pocketforge-os/test-node-hw/mechanical/dut-cradle-v1/README.md

# PocketForge parametric DUT cradle v1

This is the camera-facing half of a PocketForge test harness: a reusable
**device carrier / DUT cradle** that fixes a handheld at a repeatable optical
datum without loading its controls, triggers, display, or exposed rear wiring.
The first mechanical family supports both the **TrimUI Smart Pro** and
**TrimUI Smart Pro S**, which share the same enclosure and control layout.
The compact portrait profile supports the **TrimUI Brick** while reusing the
same proven M3/keyway hook mechanism; see
[`README-trimui-brick.md`](README-trimui-brick.md).
That profile remains a qualification candidate until the owner accepts its
printed fit, retention, service clearance, and webcam framing.
The landscape **Powkiddy X55** candidate preserves the owner-traced contact
outline, three provisional local-depth hook profiles, crowded top/bottom edge
keep-outs, and open short ends; see
[`README-powkiddy-x55.md`](README-powkiddy-x55.md). Print its fit coupon first;
exact local depths remain gated by `tsp-bcx.21.28`.

The carrier is deliberately not a tight six-point vise. Two lower hooks carry
the device, the removable upper pair captures it, and the two lateral hooks are
loose datums. Every hook has a rear shelf, so the six perimeter contacts—not
the open PCB and not the shoulder triggers—establish an 11 mm carrier gap.

## Why separate parts

OpenSCAD modules are the template mechanism:

- [`lib/dut-cradle-library.scad`](lib/dut-cradle-library.scad) contains the
  reusable carrier fastener and J-hook geometry.
- [`trimui-smart-pro-family-cradle.scad`](trimui-smart-pro-family-cradle.scad)
  contains the shared mechanical profile: shell dimensions, optical offset,
  contact windows, hook poses, labels, and common 4040 datum.
- [`trimui-smart-pro-s-cradle.scad`](trimui-smart-pro-s-cradle.scad) and
  [`trimui-smart-pro-cradle.scad`](trimui-smart-pro-cradle.scad) are tiny model
  wrappers that supply `TrimUI Smart Pro S / TG5050` or
  `TrimUI Smart Pro / TG5040` as the raised marketing/internal-model title.
- [`trimui-brick-cradle.scad`](trimui-brick-cradle.scad) supplies the Brick's
  portrait plate, stepped-depth preview, five contact poses, and two hook
  profiles while importing the same reusable hook implementation.
- [`powkiddy-x55-cradle.scad`](powkiddy-x55-cradle.scad) supplies the X55's
  247 × 175 mm landscape carrier, curved-shell preview, six contact poses, and
  three edge-specific hook profiles.

A future handheld gets a new wrapper/profile while reusing the library. The
carrier envelope and eight corner frame anchors remain standardized; the
device outline, service aperture, safe contacts, and optical center may change.
Every device profile reserves a dedicated top margin for a centered, horizontal
device-name title box; names do not use side margins or share space with clamp
mounts. Orientation labels may move to suit the device-specific keep-outs.

`PART` selects independent printable objects:

| `PART` | Result |
|---|---|
| `assembly` | Default presentation; exports only the carrier because DUT, safe windows, and installed hooks are background geometry |
| `plate` | Carrier plate |
| `presentation_body` | Presentation-only carrier body below the filament-change layer; do not print separately |
| `presentation_labels` | Presentation-only title, border, and orientation labels for the selected wrapper; do not print separately |
| `title_text` | Audit-only export of the registered device title with its production font, size, and stroke growth; do not print separately |
| `hook` | One J-hook, already laid on its strong printing side |
| `hook_set` | Six production J-hooks arranged for one print |
| `installed_hooks` | Presentation-only mesh of all six hooks at their installed carrier coordinates; do not print |
| `fit_coupon` | Three throat/nut variants plus the production screw-slot/keyway coupon |

There is only one hook implementation and one single-hook export. `hook_set`
instances that same parameterized module six times for slicer convenience; it
does not duplicate source geometry. A future device family reuses the library
and supplies its own throat, stand-off, fastener, and contact parameters.

## Print the coupon first

```sh
make build/fit-coupon.stl
```

The three hooks all use the production 11.3 mm throat and are ordered
left-to-right by M3 nut-pocket size:

1. 5.5 mm across flats;
2. 5.6 mm across flats (production default);
3. 5.7 mm across flats.

The detached coupon plate contains the production 3.5 mm M3 adjustment slot
and shallow anti-rotation keyway. Check the actual device edge at all proposed
contact regions: 11.3 mm is the owner-corrected internal capture gap after the
first physical fit, not a claim that shell thickness is uniform. A thin 0.5–1
mm felt or TPU contact pad is recommended for the final hooks.

## Build and validate

```sh
make preview
make validate
```

Generated STLs and PNGs live under `build/`, remain uncommitted, and are
published as a GitHub Actions artifact on relevant pushes. The main outputs are
`trimui-smart-pro-s-carrier.stl`, `trimui-smart-pro-carrier.stl`, `j-hook.stl`,
and `j-hook-set.stl`, plus the `trimui-brick-*` carrier/hook/coupon exports
listed in the Brick README. The additional
`trimui-smart-pro-family-installed-hooks.stl` is a presentation asset consumed
by the parent chassis model; it is deliberately separate from both production
carrier exports and must not be sent to a slicer. The generated family carrier
body plus base/S label meshes are likewise presentation-only: together they
preserve the white-body/black-label material split in imported chassis views,
while each production carrier remains one unified printable STL.

Validation parses every repository OpenSCAD source, renders all meshes, proves
the 247 × 200 mm plate fits the conservative 247 × 207 mm Prusa envelope,
rejects an undersized hook throat, and proves preview-only geometry cannot leak
into either carrier export. A family-equivalence guard also exports both plates
without labels and proves their mechanical meshes are byte-for-byte equivalent
at the triangle level; the raised title is the only model difference.
Validation also bounds-checks the presentation-only installed-hook mesh so the
chassis view cannot silently drift away from the accepted six-hook layout.
Brick guards independently reject a non-flat front datum, rear finger
clearance below 8 mm, contact on the lower corner transition, insufficient
print-foot area, and title/mount overlap. The profile registry also exports the
actual title text mesh for every registered device and requires at least 2.4 mm
of clearance from all four inner title-border edges.

## Qualified geometry regression

The fit-bearing Smart Pro family geometry is physically qualified, not merely
renderable. The owner accepted the final carrier/retention fit on 2026-07-21
under Bead `tsp-bcx.21.22`; the accepted settings are the 11.3 mm hook throat,
11 mm trigger/rear gap, 5.6 mm nut pocket, and 2.4 mm nut-capture wall.

[`qualification/trimui-smart-pro-family-v1.json`](qualification/trimui-smart-pro-family-v1.json)
records normalized geometry identities and review metrics for:

- the unlabelled, fit-bearing carrier body;
- one production J-hook;
- the six-hook print set; and
- the fit coupon used to establish the retained dimensions.

Labels and the installed-hook presentation mesh are deliberately excluded.
They do not establish contact with the DUT. The manifest stores no STL:
production meshes remain generated under `build/`.

Run the check directly or through full validation:

```sh
make validate-qualified validate-qualified-mutation
make validate
```

The fingerprint quantizes coordinates to 0.0001 mm and then ignores STL
headers, normals, binary attribute bytes, facet order, winding, starting
vertex, and signed zero. This makes ASCII and binary exports of identical
geometry share an identity. The quantum is 0.1 micrometre—far below the target
FDM process—so it does not mask a printable change. Bounds, area, volume, and
topology remain alongside the digest as reviewable characterization data.

The mutation guard renders a valid, in-bounds hook with an 11.4 mm throat. It
must fail the qualified fingerprint even though ordinary OpenSCAD and bounds
checks pass. Relevant pull requests run this complete check, not lint alone.
The CI compatibility lock is Ubuntu 24.04 plus the
`openscad=2021.01-6build4` package; the checker also requires OpenSCAD to report
version 2021.01.

### Intentional geometry changes

A failing qualification check is not an instruction to refresh the manifest.
First inspect the geometric change, print the appropriate coupon or full
holder, and obtain explicit physical acceptance against the named device
hardware revision. The record command is intentionally separate from every
normal Make/CI path and refuses to operate without an acceptance reference and
`--confirm-physical-acceptance`:

```sh
python3 scripts/qualified_geometry.py --root . record \
  --manifest qualification/trimui-smart-pro-family-v1.json \
  --acceptance-ref <bead-or-approval-record> \
  --accepted-source-revision <physically-tested-commit> \
  --characterized-source-revision <current-commit> \
  --accepted-on <YYYY-MM-DD> \
  --confirm-physical-acceptance
```

Without `--write`, that command prints a review candidate and changes nothing.
Add `--write` only as the deliberate source edit after physical qualification;
review the manifest diff like any other fit-bearing CAD change.

The normalized digest answers “is this the same geometry?” Raw STL SHA256
answers “is this the same distributed file?” Release print packs should carry
raw checksums, but representation-dependent file hashes are not substitutes
for this qualification gate. Neither form proves that future measurements are
correct: a new device or changed contact surface still requires an in-hand fit
gate.

## Hardware and assembly

- 6 printed J-hooks (PETG preferred);
- 6 × M3 nuts (coupon tests 5.5, 5.6, and 5.7 mm across-flat pockets);
- 6 × M3 × 12 mm pan-head machine screws;
- 6 × M3 washers under the plate;
- optional thin felt/TPU pads at shell contacts;
- 8 heavy-duty cable ties for the 4040-frame anchors.

Assembly order:

1. Insert each nut from the top of its hook base.
2. Loosely install the two bottom hooks from the rear of the carrier. Their
   rectangular keys must enter the shallow guide channels.
3. Lower the DUT onto the two rear shelves. The screws lock hook position; do
   **not** tighten the hooks inward to squeeze the shell.
4. Set the side hooks with roughly 0.6 mm play and tighten them.
5. Install the top hooks last with roughly 0.45 mm play. These are the only
   hooks normally removed when servicing the DUT.
6. Confirm every trigger, button, connector, speaker/vent, wire, and the full
   display remains free before mounting the carrier to the 4040 frame.

M3 × 12 is the calculated starting length for a 3.2 mm carrier, 4.4 mm hook
base, washer, and 2.4 mm-class nut. Verify it on the coupon. The screw and nut
sit 8 mm outside the shell edge, so excess length cannot point into the DUT.
Each nut pocket has a complete 2.4 mm radial capture wall—three extrusion widths
with the lab's 0.8 mm nozzle—so tightening torque cannot spin the nut out through
the side of the formerly narrow base.

## Profile measurements and assumptions

| Parameter | Current value | Status |
|---|---:|---|
| Shell envelope | 188.35 × 79.77 mm | Owner measurement |
| Modeled local edge depth | 10.7 mm | Preview proxy derived from fit gap and passive clearance |
| Production hook throat | 11.3 mm | Owner correction after first physical fit |
| Rear carrier gap | 11.0 mm | Owner correction: original 6 mm + 5 mm trigger clearance |
| Front lip overlap | 2.8 mm | Design choice; below screen margin |
| Rear service aperture | 158 × 52 mm | Design choice; leaves perimeter structure |
| Top-left safe window | 35.41–50 mm from left | Interpreted from nested sketch dimensions |
| Top-right safe window | 34–50 mm from right | Interpreted from nested sketch dimensions |
| Bottom safe windows | 24–35 mm from each end | Interpreted from nested sketch dimensions |
| Active screen proxy | 110.8 × 62.3 mm | Preview-only provisional estimate |
| Screen optical offset | [0, 0] | Independent, awaiting camera registration |

The paper sketch appears to mark each mountable region between the two nested
dimension endpoints; clamp centers use those interval midpoints. Green bars in
the assembly preview make this assumption visible. Adjust the four named safe
windows if that reading is wrong—nothing in the reusable hook changes.

## Print settings

- Carrier: flat, labels upward, no support; PETG preferred.
- Hooks: the STL already lays each hook on its broad side so layers run through
  the J profile; no support.
- Start at 0.30–0.40 mm layers for the 0.8 mm nozzle, 4 perimeters, 5 top/bottom
  layers, and 20–30% gyroid. Use the slicer's preview to verify the 1.2 mm-deep
  anti-rotation channels and 1.2 mm raised labels survive the selected layer
  height.
- The device name and TOP/BOTTOM markings use the profile's locked Liberation
  face with 0.35 mm stroke expansion. Smart Pro and Smart Pro S retain their
  passing 10 mm titles; Brick uses 8.5 mm and X55 uses 11.0 mm so every title
  remains at least three 0.8 mm nozzle widths inside its border.
- Print the carrier body in white, then change to black at `plate_thickness`
  (3.2 mm), where the raised title, title-box border, and TOP/BOTTOM markings
  begin. The OpenSCAD assembly uses this same datum for its material colors.
- The large central aperture is intentional: it saves material, improves
  airflow, keeps the open PCB/wiring untouched, and permits rear service.
