pocketforge-os/test-node-hw/mechanical/dut-fixture-v1/VIENON-USB-001-PROVENANCE.md

# VIENON Usb-001 model provenance

`vienon-usb-001.scad` is an original PocketForge reconstruction of the black
bottom-facing USB hub installed on the fixture. No listing image or third-party
geometry is redistributed.

## Identity and dimensions

- Owner-supplied listing: <https://www.amazon.com/dp/B09MLRPTT2>
- Brand/model: VIENON Usb-001, UPC 743890190214
- Product: ultra-slim four-port USB-A hub with fixed one-foot upstream lead
- Published envelope: 3.94 × 1.18 × 0.39 in, approximately
  100 × 30 × 10 mm
- Port population: one USB 3.0 plus three USB 2.0 data ports and blue status
  indicator. Gallery revisions color all four receptacle tongues blue; the
  model keeps one blue USB 3.0 tongue and three dark USB 2.0 tongues according
  to the listing's explicit interface specification.
- Fixture pose: four downstream ports face −Y/bottom and the fixed upstream
  lead exits +X/right, matching the owner photograph

The prior 105 × 24 mm analytical envelope was an allowed estimate. The exact
body is centred on the physically proven X tie axes. Only the presentation
body moves 2 mm toward the open plate edge; the printable tie slots are
unchanged.

## Preserved references

The Amazon gallery was saved outside git under
`/home/matt/Downloads/pocketforge-reference/final-fixture-components/vienon-usb-001/B09MLRPTT2/`
on 2026-07-26. The adjacent `SOURCES.txt` records every file and hash. Key
files are:

- Hero: `3129YkhBboL.jpg`,
  SHA-256 `3c751f1dbf784083af1d7ea2ee700e7ddbccd587d77e17dfada458fb3011dc63`
- Four-device usage view: `51TMyUDboPL.jpg`,
  SHA-256 `299d28ef6c14c95fc19dbe0de5367313f78e47066a62850ba105745512a0ebe7`
- Internal population view: `516wx7kZkOL.jpg`,
  SHA-256 `f5161ac65919ef52bc03edad6fed35815246ff483af24d3269169fc67b3c423a`
- Owner installed-state photo:
  SHA-256 `01ecb407d5862a442ac77eb52c60763db44b5067d2c55e2e0d08fc6aed7d51e5`

## Geometry and license decision

Exact ASIN, UPC, model-number, STEP, STL, and CAD searches found no matching
model with a redistribution license. The source reconstructs the crowned ABS
shell, four receptacles, differentiated port tongues, LED, seam, fixed cable,
strain relief, and visible upstream USB-A plug.

Searches used `B09MLRPTT2`, `743890190214`, `VIENON Usb-001`, and their
combinations with `STEP`, `STL`, `CAD`, and `3D model` across general search
and public CAD-model indexes. No exact geometry candidate was found, so there
is no third-party author or license to carry forward; visually similar
unbranded four-port hubs were rejected as unverifiable revisions.
