pocketforge-os/test-node-hw/mechanical/dut-cradle-v1/trimui-brick-cradle.scad

/*
 * PocketForge reusable DUT cradle — TrimUI Brick profile
 *
 * Coordinates: X left-to-right, Y bottom-to-top, Z toward the webcam; mm.
 * The Brick has a stepped rear shell.  Per-hook rear shelves compensate for
 * that step so the front glass remains parallel to the carrier and camera.
 *
 * PART choices: assembly, plate, presentation_body, presentation_labels,
 * bottom_support, side_hook, upper_hook, hook_set, fit_coupon.
 * Preview geometry is background-only and cannot leak into printable exports.
 */

include <lib/dut-cradle-library.scad>;

PART = "assembly";
DEVICE_LABEL = "TrimUI Brick / TG3040";
SHOW_DEVICE = true;
SHOW_HOOKS = true;
SHOW_KEEP_OUTS = true;
SHOW_LABELS = true;

$fn = 48;
epsilon = 0.05;

// ---- Carrier / printer datum ---------------------------------------------
printer_bed = [250, 210];
printer_edge_margin = 1.5;
printable_bed = printer_bed - [2 * printer_edge_margin,
                               2 * printer_edge_margin];

// The 205 mm height reserves the same top-title convention as the accepted
// Smart Pro carriers while staying inside the conservative 207 mm Y envelope.
plate_size = [180, 205];
plate_thickness = 3.2;
plate_corner_radius = 4.0;

frame_tie_slot = [12.0, 5.5];
frame_tie_edge_inset = 7.0;
frame_tie_corner_offset = 18.0;
frame_tie_features = [
    ["bottom_left_bottom", [frame_tie_corner_offset, frame_tie_edge_inset], 0],
    ["bottom_left_left", [frame_tie_edge_inset, frame_tie_corner_offset], 90],
    ["bottom_right_bottom",
     [plate_size.x - frame_tie_corner_offset, frame_tie_edge_inset], 0],
    ["bottom_right_right",
     [plate_size.x - frame_tie_edge_inset, frame_tie_corner_offset], 90],
    ["top_left_top",
     [frame_tie_corner_offset, plate_size.y - frame_tie_edge_inset], 0],
    ["top_left_left",
     [frame_tie_edge_inset, plate_size.y - frame_tie_corner_offset], 90],
    ["top_right_top",
     [plate_size.x - frame_tie_corner_offset,
      plate_size.y - frame_tie_edge_inset], 0],
    ["top_right_right",
     [plate_size.x - frame_tie_edge_inset,
      plate_size.y - frame_tie_corner_offset], 90]
];

// ---- Owner-measured Brick mechanical profile -----------------------------
device_name = DEVICE_LABEL;
device_body_size = [72.8, 110.75];
device_bottom_corner_radius = 8.5;
device_origin = (plate_size - device_body_size) / 2;
device_centre = device_origin + device_body_size / 2;

// The lower 60 mm of the shell is 20 mm deep; the upper shell is 12 mm deep.
// Supporting the two regions 8 mm apart holds their shared front face flat.
lower_region_height = 60.0;
lower_body_depth = 20.0;
upper_body_depth = 12.0;
minimum_rear_clearance = 8.0;
lower_rear_gap = 10.0;
upper_rear_gap = lower_rear_gap + lower_body_depth - upper_body_depth;

// 3.2-inch 4:3 panel geometry.  Only the top margin is a hook safety datum;
// the rest is a preview until a direct glass measurement is needed.
screen_size = [65.02, 48.77];
screen_top_margin = 1.8;
screen_origin = [
    device_origin.x + (device_body_size.x - screen_size.x) / 2,
    device_origin.y + device_body_size.y - screen_top_margin - screen_size.y
];

// Large open back for trigger testing, airflow, wiring, and a finger behind
// the DUT.  The remaining perimeter carries all five clamp interfaces.
rear_service_window = [56.0, 86.0];
rear_service_origin = device_centre - rear_service_window / 2;
rear_service_radius = 7.0;

// ---- Five passive contacts -----------------------------------------------
// Two rear-only bottom supports carry weight without crossing the bottom I/O
// insertion plane. Two side hooks are loose datums, and the narrow upper hook
// is offset left of the centred USB-host path and only prevents escape.
bottom_contact_inset = 18.0;
// Keep the complete 9 mm side-contact band above the 8.5 mm lower corner arc.
lower_side_contact_height = 14.0;
upper_contact_inset = 17.0;

lower_throat = lower_body_depth + 0.6;
upper_throat = upper_body_depth + 0.6;

// pose = [name, exact shell-edge contact point, inward angle, play, kind]
clamp_poses = [
    ["bottom_left",
     [device_origin.x + bottom_contact_inset, device_origin.y],
     90, 0.25, "bottom"],
    ["bottom_right",
     [device_origin.x + device_body_size.x - bottom_contact_inset,
      device_origin.y],
     90, 0.25, "bottom"],
    ["left_lower_datum",
     [device_origin.x, device_origin.y + lower_side_contact_height],
     0, 0.60, "side"],
    ["right_lower_datum",
     [device_origin.x + device_body_size.x,
      device_origin.y + lower_side_contact_height],
     180, 0.60, "side"],
    ["upper_retainer",
     [device_origin.x + upper_contact_inset,
      device_origin.y + device_body_size.y],
     -90, 0.45, "upper"]
];

function pose_name(pose) = pose[0];
function pose_contact(pose) = pose[1];
function pose_angle(pose) = pose[2];
function pose_play(pose) = pose[3];
function pose_kind(pose) = pose[4];
function pose_inward(pose) = pf_rotate_2d([1, 0], pose_angle(pose));
function pose_surface(pose) =
    pf_add_2d(pose_contact(pose),
              pf_scale_2d(-pose_play(pose), pose_inward(pose)));

// ---- Shared hook hardware / two contact profiles -------------------------
bottom_support_width = 9.0;
side_hook_width = 9.0;
upper_hook_width = 6.0;
hook_wall = 4.0;
side_lip_depth = 3.0;
upper_lip_depth = 1.2;
hook_lip_thickness = 4.0;
bottom_support_depth = 4.0;
side_support_depth = 4.0;
upper_support_depth = 3.0;
hook_support_thickness = 3.2;
bottom_io_min_z = 7.0;
bottom_io_clearance = 1.0;
bottom_support_stem_height = lower_rear_gap + 4.0;
hook_base_outward = 13.0;
hook_base_inward = 4.0;
hook_base_height = 4.4;
hook_base_radius = 1.5;
// Keep a Smart-Pro-width spine/base for a full broad-side first layer while
// leaving the 9/6 mm shell-contact shelves and lips narrow. This preserves the
// already-printed carrier's keyway locations and all device keep-outs.
hook_spine_width = 10.4;

m3_clearance = 3.5;
m3_nut_across_flats = 5.6;               // Smart Pro owner-validated press fit
m3_nut_depth = 2.8;
m3_nut_capture_wall = 2.4;
hook_screw_offset = [-8.0, -3.5];
hook_key_offset = [-8.0, 3.5];
hook_key_size = [4.0, 3.2];
hook_key_clearance = 0.35;
hook_keyway_depth = 1.2;
hook_adjustment = 8.0;
print_face_margin = 0.10;

// ---- Labels for the 0.8 mm nozzle ----------------------------------------
label_height = 1.2;
label_stroke_growth = 0.35;
label_font = "Liberation Sans:style=Regular";
title_box_size = [124.0, 24.0];
title_box_centre = [plate_size.x / 2, plate_size.y - 15.0];
title_font_size = 8.5;
title_border_inner_inset = 1.2;
orientation_font_size = 10.5;
label_feature_clearance = 2.4;  // three 0.8 mm nozzle widths
carrier_body_color = [0.88, 0.88, 0.84];
carrier_label_color = [0.02, 0.02, 0.02];

top_label_center = [plate_size.x - 25.0, plate_size.y - 36.0];
bottom_label_center = [plate_size.x / 2, 11.5];

// ---- Explicit mechanical invariants --------------------------------------
lower_front_datum = lower_rear_gap + lower_throat;
upper_front_datum = upper_rear_gap + upper_throat;
top_usb_keepout = [
    device_origin.x + device_body_size.x / 2 - 8.0,
    device_origin.x + device_body_size.x / 2 + 8.0
];
upper_contact_window = [
    device_origin.x + upper_contact_inset - upper_hook_width / 2,
    device_origin.x + upper_contact_inset + upper_hook_width / 2
];
title_box_min = title_box_centre - title_box_size / 2;
title_box_max = title_box_centre + title_box_size / 2;
top_left_slot_outer_x = frame_tie_corner_offset + frame_tie_slot.x / 2;
top_right_slot_inner_x = plate_size.x - frame_tie_corner_offset -
                         frame_tie_slot.x / 2;
upper_hook_surface = pose_surface(clamp_poses[4]);
upper_hook_screw_point = pf_add_2d(
    upper_hook_surface,
    pf_rotate_2d(hook_screw_offset, pose_angle(clamp_poses[4]))
);
upper_mount_outer_y = max(
    upper_hook_surface.y + hook_base_outward,
    upper_hook_screw_point.y + (hook_adjustment + m3_clearance) / 2
);
top_label_outer_y = top_label_center.y +
                    orientation_font_size / 2 + label_stroke_growth;
bottom_label_outer_y = bottom_label_center.y +
                       orientation_font_size / 2 + label_stroke_growth;
bottom_left_surface = pose_surface(clamp_poses[0]);
bottom_left_screw_point = pf_add_2d(
    bottom_left_surface,
    pf_rotate_2d(hook_screw_offset, pose_angle(clamp_poses[0]))
);
bottom_mount_inner_y = bottom_left_screw_point.y -
                       (hook_adjustment + m3_clearance) / 2;

assert(plate_size.x <= printable_bed.x && plate_size.y <= printable_bed.y,
       "Brick carrier exceeds the conservative Prusa printable envelope");
assert(lower_rear_gap >= minimum_rear_clearance,
       "Brick lower rear gap must preserve finger access");
assert(upper_rear_gap >= minimum_rear_clearance,
       "Brick upper rear gap must preserve trigger access");
assert(abs(lower_front_datum - upper_front_datum) < 0.01,
       "Brick front contact plane must remain flat across shell step");
assert(lower_throat > lower_body_depth && upper_throat > upper_body_depth,
       "Brick hook throats must retain positive passive clearance");
assert(upper_lip_depth < screen_top_margin,
       "Brick upper lip could cover active screen pixels");
assert(upper_contact_window.y < top_usb_keepout.x,
       "Brick upper retainer entered the centred USB-host keep-out");
assert(title_box_min.x >= top_left_slot_outer_x + label_feature_clearance &&
       title_box_max.x <= top_right_slot_inner_x - label_feature_clearance,
       "Brick top title box entered a top 4040 frame slot lane");
assert(title_box_min.y >= upper_mount_outer_y + label_feature_clearance,
       "Brick top title box entered the upper hook adjustment sweep");
assert(top_label_outer_y + label_feature_clearance <= title_box_min.y,
       "Brick TOP orientation label entered the device title box");
assert(bottom_label_outer_y + label_feature_clearance <=
           bottom_mount_inner_y,
       "Brick BOTTOM label entered a lower hook adjustment sweep");
assert(lower_side_contact_height - side_hook_width / 2 >
           device_bottom_corner_radius &&
       lower_side_contact_height + side_hook_width / 2 <
           lower_region_height,
       "The complete Brick side-contact band must land on the straight thick shell");
assert(bottom_support_stem_height <=
           lower_rear_gap + bottom_io_min_z - bottom_io_clearance,
       "Brick bottom supports entered the bottom I/O insertion plane");
assert(m3_nut_capture_wall >= 2.4,
       "Brick M3 nut capture wall must remain at least three nozzle widths");
assert(hook_key_offset.y + hook_key_size.y / 2 + print_face_margin <=
           hook_spine_width / 2,
       "Brick anti-rotation keys must not protrude below the broad print face");
assert(rear_service_origin.x > device_origin.x &&
       rear_service_origin.y > device_origin.y &&
       rear_service_origin.x + rear_service_window.x <
           device_origin.x + device_body_size.x &&
       rear_service_origin.y + rear_service_window.y <
           device_origin.y + device_body_size.y,
       "Brick service aperture must remain inside the DUT footprint");

// ---- Carrier --------------------------------------------------------------
module embossed_text(point, message, size, rotation = 0,
                     halign = "center") {
    translate([point.x, point.y, plate_thickness])
        linear_extrude(height = label_height)
            rotate(rotation)
                offset(delta = label_stroke_growth)
                    text(message, size = size, halign = halign,
                         valign = "center",
                         font = label_font);
}

// Preserve the 124 x 24 mm placard and orientation-label sizes while keeping
// the longer marketing/model title three nozzle widths inside its border.
module carrier_title_contract() {
    assert(is_undef(EXPECTED_TITLE_BOX_SIZE) ||
           title_box_size == EXPECTED_TITLE_BOX_SIZE,
           "Carrier title box size drifted from its profile contract");
    assert(is_undef(EXPECTED_TITLE_BOX_CENTRE) ||
           title_box_centre == EXPECTED_TITLE_BOX_CENTRE,
           "Carrier title box centre drifted from its profile contract");
    assert(is_undef(EXPECTED_TITLE_FONT_SIZE) ||
           title_font_size == EXPECTED_TITLE_FONT_SIZE,
           "Carrier title font size drifted from its profile contract");
    assert(is_undef(EXPECTED_TITLE_BORDER_INSET) ||
           title_border_inner_inset == EXPECTED_TITLE_BORDER_INSET,
           "Carrier title border inset drifted from its profile contract");
}

module title_border(centre, size) {
    translate([centre.x - size.x / 2,
               centre.y - size.y / 2,
               plate_thickness]) {
        linear_extrude(height = label_height)
            difference() {
                pf_rounded_rect_2d(size, 2.0);
                translate([title_border_inner_inset,
                           title_border_inner_inset])
                    pf_rounded_rect_2d(
                        size - [2 * title_border_inner_inset,
                                2 * title_border_inner_inset],
                        title_border_inner_inset
                    );
            }
    }
}

module carrier_title_text() {
    carrier_title_contract();
    translate([title_box_centre.x, title_box_centre.y, plate_thickness])
        linear_extrude(height = label_height)
            offset(delta = label_stroke_growth)
                text(device_name, size = title_font_size,
                     halign = "center", valign = "center",
                     font = label_font);
}

module carrier_labels() {
    title_border(title_box_centre, title_box_size);
    carrier_title_text();
    embossed_text(top_label_center, "TOP", orientation_font_size);
    embossed_text(bottom_label_center, "BOTTOM",
                  orientation_font_size);
}

module carrier_body() {
    difference() {
        pf_rounded_prism(
            [plate_size.x, plate_size.y, plate_thickness],
            plate_corner_radius
        );

        pf_frame_tie_holes(
            frame_tie_features, frame_tie_slot,
            plate_thickness + 2 * epsilon
        );

        translate([rear_service_origin.x, rear_service_origin.y,
                   -epsilon])
            linear_extrude(height = plate_thickness + 2 * epsilon)
                pf_rounded_rect_2d(rear_service_window,
                                   rear_service_radius);

        for (pose = clamp_poses)
            pf_clamp_mount_cutouts(
                pose_surface(pose), pose_angle(pose), plate_thickness,
                hook_screw_offset, hook_key_offset, hook_adjustment,
                m3_clearance, hook_key_size, hook_key_clearance,
                hook_keyway_depth, epsilon
            );
    }
}

module carrier_plate() {
    union() {
        carrier_body();
        if (SHOW_LABELS)
            carrier_labels();
    }
}

// The physical carrier changes from white to black exactly where its raised
// geometry begins. Keep that split presentation-only: PART="plate" remains
// one fused printable mesh.
module carrier_presentation() {
    color(carrier_body_color) carrier_body();
    if (SHOW_LABELS)
        color(carrier_label_color) carrier_labels();
}

module one_hook_installed(pose) {
    upper = pose_kind(pose) == "upper";
    bottom = pose_kind(pose) == "bottom";
    if (bottom)
        pf_installed_j_hook(
            pose_surface(pose), pose_angle(pose), plate_thickness,
            lower_throat, lower_rear_gap, bottom_support_width, hook_wall,
            0, 0, bottom_support_depth, hook_support_thickness,
            hook_base_outward, hook_base_inward, hook_base_height,
            hook_base_radius, hook_screw_offset, hook_key_offset,
            m3_clearance, m3_nut_across_flats, m3_nut_depth,
            m3_nut_capture_wall, hook_key_size, hook_keyway_depth,
            epsilon, hook_spine_width, bottom_support_stem_height
        );
    else
        pf_installed_j_hook(
            pose_surface(pose), pose_angle(pose), plate_thickness,
            upper ? upper_throat : lower_throat,
            upper ? upper_rear_gap : lower_rear_gap,
            upper ? upper_hook_width : side_hook_width, hook_wall,
            upper ? upper_lip_depth : side_lip_depth,
            hook_lip_thickness,
            upper ? upper_support_depth : side_support_depth,
            hook_support_thickness, hook_base_outward, hook_base_inward,
            hook_base_height, hook_base_radius, hook_screw_offset,
            hook_key_offset, m3_clearance, m3_nut_across_flats,
            m3_nut_depth, m3_nut_capture_wall, hook_key_size,
            hook_keyway_depth, epsilon, hook_spine_width
        );
}

module bottom_support_printable(throat = lower_throat) {
    pf_print_oriented_j_hook(
        throat, lower_rear_gap, bottom_support_width, hook_wall,
        0, 0, bottom_support_depth, hook_support_thickness,
        hook_base_outward, hook_base_inward, hook_base_height,
        hook_base_radius, hook_screw_offset, hook_key_offset, m3_clearance,
        m3_nut_across_flats, m3_nut_depth, m3_nut_capture_wall,
        hook_key_size, hook_keyway_depth, epsilon, hook_spine_width,
        bottom_support_stem_height
    );
}

module side_hook_printable(throat = lower_throat) {
    pf_print_oriented_j_hook(
        throat, lower_rear_gap, side_hook_width, hook_wall,
        side_lip_depth, hook_lip_thickness, side_support_depth,
        hook_support_thickness, hook_base_outward, hook_base_inward,
        hook_base_height, hook_base_radius, hook_screw_offset,
        hook_key_offset, m3_clearance, m3_nut_across_flats,
        m3_nut_depth, m3_nut_capture_wall, hook_key_size,
        hook_keyway_depth, epsilon, hook_spine_width
    );
}

module upper_hook_printable(throat = upper_throat) {
    pf_print_oriented_j_hook(
        throat, upper_rear_gap, upper_hook_width, hook_wall,
        upper_lip_depth, hook_lip_thickness, upper_support_depth,
        hook_support_thickness, hook_base_outward, hook_base_inward,
        hook_base_height, hook_base_radius, hook_screw_offset,
        hook_key_offset, m3_clearance, m3_nut_across_flats,
        m3_nut_depth, m3_nut_capture_wall, hook_key_size,
        hook_keyway_depth, epsilon, hook_spine_width
    );
}

module hook_set() {
    for (column = [0 : 1]) {
        translate([column * 23, 0, 0]) bottom_support_printable();
        translate([column * 23, 40, 0]) side_hook_printable();
    }
    translate([46, 0, 0]) upper_hook_printable();
}

module mount_coupon_plate() {
    coupon_size = [30, 21];
    coupon_surface = [18, coupon_size.y / 2];
    difference() {
        pf_rounded_prism([coupon_size.x, coupon_size.y, plate_thickness], 2);
        pf_clamp_mount_cutouts(
            coupon_surface, 0, plate_thickness, hook_screw_offset,
            hook_key_offset, hook_adjustment, m3_clearance, hook_key_size,
            hook_key_clearance, hook_keyway_depth, epsilon
        );
    }
}

module fit_coupon() {
    bottom_support_printable();
    translate([24, 0, 0]) side_hook_printable();
    translate([48, 0, 0]) upper_hook_printable();
    translate([22, 42, 0]) mount_coupon_plate();
}

// ---- Preview-only device / keep-outs -------------------------------------
module brick_outline_2d() {
    radius = device_bottom_corner_radius;
    union() {
        translate([0, radius])
            square([device_body_size.x, device_body_size.y - radius]);
        translate([radius, 0])
            square([device_body_size.x - 2 * radius, radius]);
        translate([radius, radius]) circle(r = radius);
        translate([device_body_size.x - radius, radius]) circle(r = radius);
    }
}

module brick_device_preview() {
    front_plane = plate_thickness + lower_front_datum - 0.6;

    color([0.12, 0.14, 0.16, 0.62]) {
        translate([device_origin.x, device_origin.y,
                   plate_thickness + lower_rear_gap])
            intersection() {
                linear_extrude(height = lower_body_depth)
                    brick_outline_2d();
                cube([device_body_size.x, lower_region_height,
                      lower_body_depth]);
            }

        translate([device_origin.x, device_origin.y,
                   plate_thickness + upper_rear_gap])
            intersection() {
                linear_extrude(height = upper_body_depth)
                    brick_outline_2d();
                translate([0, lower_region_height, 0])
                    cube([device_body_size.x,
                          device_body_size.y - lower_region_height,
                          upper_body_depth]);
            }
    }

    color([0.10, 0.55, 0.88, 0.78])
        translate([screen_origin.x, screen_origin.y, front_plane + 0.05])
            cube([screen_size.x, screen_size.y, 0.35]);
}

module keep_out_preview() {
    front_plane = plate_thickness + lower_front_datum;

    // Active-screen top edge and the selected narrow contact window.
    color([0.15, 0.95, 0.35, 0.80])
        translate([upper_contact_window.x,
                   device_origin.y + device_body_size.y - 1,
                   front_plane + 0.5])
            cube([upper_contact_window.y - upper_contact_window.x,
                  2, 0.8]);

    // Centred top USB-host cable path; all orange/red volumes are keep-outs.
    color([1.0, 0.50, 0.08, 0.68])
        translate([top_usb_keepout.x,
                   device_origin.y + device_body_size.y - 2,
                   plate_thickness + upper_rear_gap + 2])
            cube([top_usb_keepout.y - top_usb_keepout.x, 9,
                  upper_body_depth - 4]);

    // Rear shoulder triggers project toward the carrier in the thin region.
    color([0.95, 0.12, 0.20, 0.70])
        for (trigger_x = [device_origin.x + 11,
                          device_origin.x + device_body_size.x - 24])
            translate([trigger_x,
                       device_origin.y + device_body_size.y - 18,
                       plate_thickness + upper_rear_gap - 4])
                cube([13, 12, 4]);

    // Side controls and bottom connector group remain unobstructed.
    color([1.0, 0.50, 0.08, 0.68]) {
        translate([device_origin.x - 2, device_origin.y + 77,
                   front_plane - 8])
            cube([4, 18, 8]);
        translate([device_origin.x + device_body_size.x - 2,
                   device_origin.y + 77, front_plane - 8])
            cube([4, 18, 8]);
        translate([device_origin.x + 10, device_origin.y - 6,
                   plate_thickness + lower_rear_gap + bottom_io_min_z])
            cube([45.56, 8, 7]);
    }
}

module assembly() {
    carrier_presentation();

    if (SHOW_DEVICE)
        %brick_device_preview();

    if (SHOW_KEEP_OUTS)
        %keep_out_preview();

    if (SHOW_HOOKS)
        for (pose = clamp_poses)
            %one_hook_installed(pose);
}

if (PART == "assembly") {
    assembly();
} else if (PART == "plate") {
    carrier_plate();
} else if (PART == "presentation_body") {
    carrier_body();
} else if (PART == "presentation_labels") {
    carrier_labels();
} else if (PART == "title_text") {
    carrier_title_text();
} else if (PART == "bottom_support") {
    bottom_support_printable();
} else if (PART == "side_hook" || PART == "lower_hook") {
    side_hook_printable();
} else if (PART == "upper_hook") {
    upper_hook_printable();
} else if (PART == "hook_set") {
    hook_set();
} else if (PART == "fit_coupon") {
    fit_coupon();
} else {
    assert(false, str("Unknown PART: ", PART));
}
