pocketforge-os/test-node-hw/mechanical/dut-cradle-v1/trimui-smart-pro-cradle.scad

/* TrimUI Smart Pro / TG5040 label wrapper;
 * mechanics live in the family profile. */
DEVICE_LABEL = "TrimUI Smart Pro / TG5040";
include <trimui-smart-pro-family-cradle.scad>;
