pocketforge-os/test-node-hw/mechanical/dut-cradle-v1/trimui-smart-pro-s-cradle.scad

/* TrimUI Smart Pro S / TG5050 label wrapper;
 * mechanics live in the family profile. */
DEVICE_LABEL = "TrimUI Smart Pro S / TG5050";
include <trimui-smart-pro-family-cradle.scad>;
