pocketforge-os/test-node-hw/mechanical/dut-chassis-2020-v1/pocketforge-node-chassis-usb-c.scad

/*
 * PocketForge standard 2020 test-node chassis.
 *
 * Coordinates: X left-to-right, Y camera-to-DUT (front-to-rear), Z upward.
 * The external frame envelope starts at [0, 0, 0].  All dimensions are mm.
 *
 * PART choices:
 *   assembly, presentation, stacked_assembly, corner_joint_detail, placard,
 *   placard_holder, placard_insert, placard_slide_fit_coupon,
 *   placard_system_preview,
 *   power_strip_mount_block, power_strip_mount_block_pair,
 *   power_strip_fit_coupon_set, power_strip_system_preview,
 *   ironing_test_coupon, ironing_test_coupon_set,
 *   placard_riser, placard_riser_pair,
 *   placard_spacer, placard_spacer_pair,
 *   plate_spacer, plate_spacer_set, registration_tab,
 *   registration_tab_set, gantry_joint_plate, gantry_joint_plate_set,
 *   rear_carrier_link_top, rear_carrier_link_bottom,
 *   rear_carrier_link_fit_pair, rear_carrier_link_set,
 *   dualbar_fixture_link, dualbar_fixture_link_set,
 *   usb_c_interrupter_bracket, usb_c_interrupter_installed_preview,
 *   gantry_splice_internal_bar,
 *   gantry_splice_full_collar,
 *   gantry_splice_full_collar_internal_bar,
 *   gantry_splice_full_collar_internal_bar_pair,
 *   gantry_splice_installed_preview,
 *   rail_fit_coupon, m3_slide_nut, m3_slide_nut_set,
 *   m3_slide_nut_coupon, cable_tie_anchor, cable_tie_anchor_set,
 *   production_batch_00_calibration,
 *   production_batch_01_ironed_interfaces,
 *   production_batch_02_splice_collars,
 *   production_batch_03_movable_mounts,
 *   production_batch_04_frame_hardware,
 *   production_batch_05_placard_holder,
 *   production_batch_06_device_nameplate,
 *   production_batch_06_device_nameplate_body,
 *   production_batch_06_device_nameplate_labels,
 *   production_batch_06_device_nameplate_preview,
 *   production_batch_07_wire_management,
 *   production_batch_dualbar_01_ironed_interfaces,
 *   production_batch_dualbar_02_fixture_links,
 *   guide_dualbar_suspension_detail, guide_dualbar_preload,
 *   guide_step_01_splice_uprights, guide_step_02_build_gantry,
 *   guide_step_03_open_frame, guide_step_04_install_gantry,
 *   guide_step_05_close_frame, guide_step_06_mount_carrier,
 *   guide_step_07_mount_fixture, guide_step_08_complete,
 *   guide_captive_nut_install, guide_captive_nut_count,
 *   guide_preload_channel_bar, guide_preload_map,
 *   guide_preload_width_rails, guide_parked_replacement_explained,
 *   guide_preload_depth_rails,
 *   guide_preload_camera_frame,
 *   guide_layer_aluminum, guide_layer_connectors,
 *   guide_layer_printed_hardware, guide_layer_fixture_plate,
 *   guide_layer_fixture_components, guide_layer_fixture_labels,
 *   guide_layer_fixture_boost_pcb, guide_layer_fixture_boost_dark,
 *   guide_layer_fixture_boost_adjuster, guide_layer_fixture_boost_metal,
 *   guide_layer_fixture_boost_silkscreen,
 *   guide_layer_fixture_mosfet_pcb, guide_layer_fixture_mosfet_blue,
 *   guide_layer_fixture_mosfet_dark, guide_layer_fixture_mosfet_metal,
 *   guide_layer_fixture_mosfet_led,
 *   guide_layer_fixture_mosfet_silkscreen,
 *   guide_layer_fixture_dp100_shell, guide_layer_fixture_dp100_dark,
 *   guide_layer_fixture_dp100_controls, guide_layer_fixture_dp100_screen,
 *   guide_layer_fixture_dp100_accent, guide_layer_fixture_dp100_metal,
 *   guide_layer_fixture_dp100_markings,
 *   guide_layer_fixture_bpi_pcb, guide_layer_fixture_bpi_dark,
 *   guide_layer_fixture_bpi_metal, guide_layer_fixture_bpi_gold,
 *   guide_layer_fixture_bpi_silkscreen,
 *   guide_layer_fixture_esp32_pcb, guide_layer_fixture_esp32_dark,
 *   guide_layer_fixture_esp32_metal, guide_layer_fixture_esp32_gold,
 *   guide_layer_fixture_esp32_antenna,
 *   guide_layer_fixture_esp32_silkscreen,
 *   guide_layer_fixture_antenna_dark,
 *   guide_layer_fixture_antenna_metal,
 *   guide_layer_fixture_antenna_markings,
 *   guide_layer_fixture_vienon_shell,
 *   guide_layer_fixture_vienon_dark,
 *   guide_layer_fixture_vienon_metal,
 *   guide_layer_fixture_vienon_blue,
 *   guide_layer_fixture_vienon_led,
 *   guide_layer_fixture_smays_shell,
 *   guide_layer_fixture_smays_dark,
 *   guide_layer_fixture_smays_metal,
 *   guide_layer_fixture_smays_led,
 *   guide_layer_fixture_smays_markings,
 *   guide_layer_carrier_body, guide_layer_carrier_labels,
 *   guide_layer_carrier_hooks, guide_layer_device_shell,
 *   guide_layer_device_controls, guide_layer_device_screen,
 *   guide_layer_webcam_shell, guide_layer_webcam_dark,
 *   guide_layer_webcam_glass, guide_layer_webcam_led,
 *   guide_layer_webcam_labels, guide_layer_power_strip,
 *   guide_layer_placard_holder, guide_layer_placard_insert,
 *   guide_layer_camera_frustum, guide_cable_tie_anchor_install, cutlist
 */

include <lib/pf-2020.scad>;
include <lib/usb-c-interrupter-bracket.scad>;

PART = "assembly";
// The default is the physically proven TrimUI Smart Pro chassis and is
// intentionally frozen.  The material-reduced topology must be requested
// explicitly by a device-pack layout or a development render.
CHASSIS_VARIANT = "legacy_gantry"; // legacy_gantry or dualbar_v1
CARRIER_LINK_REVISION = CHASSIS_VARIANT == "dualbar_v1" ?
    "stack_clear_v2" : "legacy_v1"; // legacy_v1 or stack_clear_v2
// Qualified layouts keep the physically accepted 44 mm plate. New candidate
// layouts request the side-clear replacement explicitly so immutable releases
// remain reproducible until the replacement is physically accepted.
GANTRY_JOINT_REVISION = "overhang_v1"; // overhang_v1 or side_clear_v2
EXAMPLE_DEVICE_VARIANT = "smart_pro"; // smart_pro, smart_pro_s, trimui_brick, or powkiddy_x55
DEVICE_LABEL = EXAMPLE_DEVICE_VARIANT == "smart_pro_s" ?
               "TrimUI Smart Pro S" :
               EXAMPLE_DEVICE_VARIANT == "trimui_brick" ?
               "TrimUI Brick / TG3040" :
               EXAMPLE_DEVICE_VARIANT == "powkiddy_x55" ?
               "Powkiddy X55" : "TrimUI Smart Pro";
PLATE_DETAIL = "proxy";       // proxy or mesh
EXTRUSION_DETAIL = "slot";    // envelope or slot
SHOW_PLATES = true;
SHOW_DEVICE = true;
SHOW_CAMERA_FRUSTUM = true;
SHOW_CONNECTOR_PROXIES = true;
SHOW_REGISTRATION_GUIDES = true;
SHOW_POWER_STRIP = true;
USB_C_INTERRUPTER_M17_PILOT_DIAMETER = 1.35;

// `make preview` stages these exact production meshes beside this source so
// presentation mode is portable with the Desktop export.  Proxy mode never
// opens them and remains safe for clean-checkout linting.
fixture_presentation_mesh =
    "build/imports/pocketforge-dut-fixture-v1.stl";
fixture_components_presentation_mesh =
    "build/imports/pocketforge-dut-fixture-components.stl";
fixture_labels_presentation_mesh =
    "build/imports/pocketforge-dut-fixture-labels.stl";
fixture_relay_pcb_presentation_mesh =
    "build/imports/pocketforge-elegoo-relay-pcb.stl";
fixture_relay_blue_presentation_mesh =
    "build/imports/pocketforge-elegoo-relay-blue.stl";
fixture_relay_dark_presentation_mesh =
    "build/imports/pocketforge-elegoo-relay-dark.stl";
fixture_relay_metal_presentation_mesh =
    "build/imports/pocketforge-elegoo-relay-metal.stl";
fixture_relay_led_presentation_mesh =
    "build/imports/pocketforge-elegoo-relay-led.stl";
fixture_relay_silkscreen_presentation_mesh =
    "build/imports/pocketforge-elegoo-relay-silkscreen.stl";
fixture_boost_pcb_presentation_mesh =
    "build/imports/pocketforge-hiletgo-xl6009-pcb.stl";
fixture_boost_dark_presentation_mesh =
    "build/imports/pocketforge-hiletgo-xl6009-dark.stl";
fixture_boost_adjuster_presentation_mesh =
    "build/imports/pocketforge-hiletgo-xl6009-adjuster.stl";
fixture_boost_metal_presentation_mesh =
    "build/imports/pocketforge-hiletgo-xl6009-metal.stl";
fixture_boost_silkscreen_presentation_mesh =
    "build/imports/pocketforge-hiletgo-xl6009-silkscreen.stl";
fixture_mosfet_pcb_presentation_mesh =
    "build/imports/pocketforge-ceksezx-mtsd001-pcb.stl";
fixture_mosfet_blue_presentation_mesh =
    "build/imports/pocketforge-ceksezx-mtsd001-blue.stl";
fixture_mosfet_dark_presentation_mesh =
    "build/imports/pocketforge-ceksezx-mtsd001-dark.stl";
fixture_mosfet_metal_presentation_mesh =
    "build/imports/pocketforge-ceksezx-mtsd001-metal.stl";
fixture_mosfet_led_presentation_mesh =
    "build/imports/pocketforge-ceksezx-mtsd001-led.stl";
fixture_mosfet_silkscreen_presentation_mesh =
    "build/imports/pocketforge-ceksezx-mtsd001-silkscreen.stl";
fixture_dp100_shell_presentation_mesh =
    "build/imports/pocketforge-alientek-dp100-shell.stl";
fixture_dp100_dark_presentation_mesh =
    "build/imports/pocketforge-alientek-dp100-dark.stl";
fixture_dp100_controls_presentation_mesh =
    "build/imports/pocketforge-alientek-dp100-controls.stl";
fixture_dp100_screen_presentation_mesh =
    "build/imports/pocketforge-alientek-dp100-screen.stl";
fixture_dp100_accent_presentation_mesh =
    "build/imports/pocketforge-alientek-dp100-accent.stl";
fixture_dp100_metal_presentation_mesh =
    "build/imports/pocketforge-alientek-dp100-metal.stl";
fixture_dp100_markings_presentation_mesh =
    "build/imports/pocketforge-alientek-dp100-markings.stl";
fixture_bpi_pcb_presentation_mesh =
    "build/imports/pocketforge-bpi-m2-zero-pcb.stl";
fixture_bpi_dark_presentation_mesh =
    "build/imports/pocketforge-bpi-m2-zero-dark.stl";
fixture_bpi_metal_presentation_mesh =
    "build/imports/pocketforge-bpi-m2-zero-metal.stl";
fixture_bpi_gold_presentation_mesh =
    "build/imports/pocketforge-bpi-m2-zero-gold.stl";
fixture_bpi_silkscreen_presentation_mesh =
    "build/imports/pocketforge-bpi-m2-zero-silkscreen.stl";
fixture_esp32_pcb_presentation_mesh =
    "build/imports/pocketforge-esp32-s3-supermini-pcb.stl";
fixture_esp32_dark_presentation_mesh =
    "build/imports/pocketforge-esp32-s3-supermini-dark.stl";
fixture_esp32_metal_presentation_mesh =
    "build/imports/pocketforge-esp32-s3-supermini-metal.stl";
fixture_esp32_gold_presentation_mesh =
    "build/imports/pocketforge-esp32-s3-supermini-gold.stl";
fixture_esp32_antenna_presentation_mesh =
    "build/imports/pocketforge-esp32-s3-supermini-antenna.stl";
fixture_esp32_silkscreen_presentation_mesh =
    "build/imports/pocketforge-esp32-s3-supermini-silkscreen.stl";
fixture_c270_shell_presentation_mesh =
    "build/imports/pocketforge-logitech-c270-shell.stl";
fixture_c270_dark_presentation_mesh =
    "build/imports/pocketforge-logitech-c270-dark.stl";
fixture_c270_glass_presentation_mesh =
    "build/imports/pocketforge-logitech-c270-glass.stl";
fixture_c270_led_presentation_mesh =
    "build/imports/pocketforge-logitech-c270-led.stl";
fixture_c270_labels_presentation_mesh =
    "build/imports/pocketforge-logitech-c270-labels.stl";
fixture_antenna_dark_presentation_mesh =
    "build/imports/pocketforge-eightwood-ewua0205-dark.stl";
fixture_antenna_metal_presentation_mesh =
    "build/imports/pocketforge-eightwood-ewua0205-metal.stl";
fixture_antenna_markings_presentation_mesh =
    "build/imports/pocketforge-eightwood-ewua0205-markings.stl";
fixture_vienon_shell_presentation_mesh =
    "build/imports/pocketforge-vienon-usb-001-shell.stl";
fixture_vienon_dark_presentation_mesh =
    "build/imports/pocketforge-vienon-usb-001-dark.stl";
fixture_vienon_metal_presentation_mesh =
    "build/imports/pocketforge-vienon-usb-001-metal.stl";
fixture_vienon_blue_presentation_mesh =
    "build/imports/pocketforge-vienon-usb-001-blue.stl";
fixture_vienon_led_presentation_mesh =
    "build/imports/pocketforge-vienon-usb-001-led.stl";
fixture_smays_shell_presentation_mesh =
    "build/imports/pocketforge-smays-microb-hub-8152-shell.stl";
fixture_smays_dark_presentation_mesh =
    "build/imports/pocketforge-smays-microb-hub-8152-dark.stl";
fixture_smays_metal_presentation_mesh =
    "build/imports/pocketforge-smays-microb-hub-8152-metal.stl";
fixture_smays_led_presentation_mesh =
    "build/imports/pocketforge-smays-microb-hub-8152-led.stl";
fixture_smays_markings_presentation_mesh =
    "build/imports/pocketforge-smays-microb-hub-8152-markings.stl";
cradle_body_presentation_mesh =
    "build/imports/trimui-smart-pro-family-carrier-body.stl";
cradle_s_labels_presentation_mesh =
    "build/imports/trimui-smart-pro-s-labels.stl";
cradle_base_labels_presentation_mesh =
    "build/imports/trimui-smart-pro-labels.stl";
cradle_labels_presentation_mesh = EXAMPLE_DEVICE_VARIANT == "smart_pro_s" ?
                                  cradle_s_labels_presentation_mesh :
                                  cradle_base_labels_presentation_mesh;
cradle_hooks_presentation_mesh =
    "build/imports/trimui-smart-pro-family-installed-hooks.stl";
device_shell_presentation_mesh =
    "build/imports/trimui-smart-pro-s-device-shell.stl";
device_controls_presentation_mesh =
    "build/imports/trimui-smart-pro-s-device-controls.stl";
device_screen_presentation_mesh =
    "build/imports/trimui-smart-pro-s-device-screen.stl";

$fn = 48;
epsilon = 0.02;

// ---- Standard chassis contract ------------------------------------------
profile_size = 20.0;

// The delivered B08C9Q2TGW connector is a cap-and-two-tongue joint, not a
// 20 mm corner cube. Width/depth rails butt into the sides of the vertical
// posts. A physically cut 360.00 mm post with one connector at each end
// measures 368 mm outside-to-outside, so each cap contributes 4 mm beyond the
// aluminum. The horizontal rails terminate flush against adjacent faces of
// each vertical post; they do not overlap one another or pass through a
// fictitious 20 mm corner cube. The compact fleet standard deliberately uses
// a rectangular frame: the already-cut 306 mm rails become width rails and
// retain 29.5 mm on each side of the limiting 247 mm carrier; the already-cut
// 318 mm rails become depth rails, adding camera/cable space. The accepted
// 360 mm posts are reused unchanged. Only the two fixture crossbars are
// trimmed from their already-cut 318 mm length to the derived 306 mm width.
structural_x_length = 306.0;
structural_y_length = 318.0;
structural_z_length = 360.0;
connector_end_overhang = 4.0;
frame_outer = [structural_x_length + 2 * profile_size,
               structural_y_length + 2 * profile_size,
               structural_z_length + 2 * connector_end_overhang];
frame_aluminum_z_min = connector_end_overhang;
frame_aluminum_z_max = frame_aluminum_z_min + structural_z_length;
// The horizontal-rail outer faces are flush with the connector-cap planes.
// They are not inset to the cut ends of the vertical aluminum posts.
outer_rail_z = [profile_size / 2,
                frame_outer.z - profile_size / 2];
frame_clear = [structural_x_length,
               structural_y_length,
               frame_outer.z - 2 * profile_size];
join_topology = "three_way_cap_flush_side_butt_B08C9Q2TGW_measured";

// SeekLiny B0DY7FKKMT is a nominal 20-series V-slot profile.  These interface
// dimensions come from the owner's delivered rail, not a generic "2020"
// drawing: A=mouth, B=depth, C=widest pocket, D=lip depth, E=web thickness,
// and F=the narrow channel face at the extrusion web.
extrusion_slot_opening = 6.73;
extrusion_slot_depth = 6.48;
extrusion_slot_pocket_width = 12.15;
extrusion_slot_lip_depth = 1.66;
extrusion_web_thickness = 1.20;
extrusion_slot_deep_width = 6.66;
extrusion_centre_bore = 4.2; // preview-only 20-series nominal

stock_length = 1000.0;
// Deliberately wide provisional allowance. It is retained for reproducible
// future-node stock planning even though node 1 reuses already-finished rails
// and needs only two 12 mm crossbar trim cuts.
cut_kerf = 3.2;

// Only the electronics/webcam fixture needs a three-axis gantry. It adds two
// split vertical uprights and two continuous horizontal crossbars. The DUT
// carrier is fixed directly to the rear outer width rails with printed links;
// its device-specific CAD already puts every screen on the shared optical
// datum. The cap-flush top/bottom depth rails leave a 328 mm clear upright.
// Keeping the uprights in the outer depth-rail X planes makes the end joints
// flat; their 164 mm halves pack into the six-stick plan.
gantry_crossbar_length = structural_x_length;
gantry_upright_length = frame_clear.z;
gantry_upright_segment_count = 2;
gantry_upright_segment_length = gantry_upright_length /
                                gantry_upright_segment_count;
gantry_clear_z_min = outer_rail_z.x + profile_size / 2;
gantry_clear_z_max = outer_rail_z.y - profile_size / 2;
gantry_upright_splice_z = gantry_clear_z_min +
                          gantry_upright_segment_length;
gantry_upright_x = [profile_size / 2,
                    frame_outer.x - profile_size / 2];
gantry_y_limits = [profile_size + profile_size / 2,
                   frame_outer.y - profile_size - profile_size / 2];

// The Pro S material-reduced variant replaces all four split upright pieces
// with two width-wise fixture bars.  The bars occupy the same adjustable Y
// datum as the proven fixture gantry, sit at the symmetric upper/lower outer
// rail centers, and join the corresponding depth rails with the same accepted
// printed indexing plates used by the proven gantry. Neither bar enters the
// outer-frame or vertical stacking load path.
fixture_bar_length = structural_x_length;
fixture_bar_z = outer_rail_z;
dualbar_join_topology =
    "three_way_cap_flush_side_butt_B08C9Q2TGW_measured_plus_two_adjustable_fixture_bars_printed_indexing_plates";
legacy_fixture_extrusion =
    gantry_upright_segment_count * 2 * gantry_upright_segment_length +
    2 * gantry_crossbar_length;
dualbar_fixture_extrusion = 2 * fixture_bar_length;
dualbar_extrusion_savings =
    legacy_fixture_extrusion - dualbar_fixture_extrusion;

// ---- Existing plate interfaces and optical registration -----------------
fixture_plate_size = [200.0, 247.0, 3.2];
// The owner-fit body remains centred on the plate at X=100, but a real C270
// lens is 19.20 mm from its left edge rather than at shell centre. Register
// the actual lens to the shared optical axis.
fixture_webcam_datum = [83.70, 132.0];
fixture_slot_inset = [19.0, 8.0];

cradle_plate_size = EXAMPLE_DEVICE_VARIANT == "trimui_brick" ?
                    [180.0, 205.0, 3.2] :
                    EXAMPLE_DEVICE_VARIANT == "powkiddy_x55" ?
                    [247.0, 175.0, 3.2] : [247.0, 200.0, 3.2];
cradle_screen_datum = EXAMPLE_DEVICE_VARIANT == "trimui_brick" ?
                      [90.0, 131.375] :
                      EXAMPLE_DEVICE_VARIANT == "powkiddy_x55" ?
                      [123.5, 85.38] : [123.5, 100.0];
cradle_slot_inset = EXAMPLE_DEVICE_VARIANT == "trimui_brick" ?
                    [18.0, 7.0] :
                    EXAMPLE_DEVICE_VARIANT == "powkiddy_x55" ?
                    [18.0, 7.0] : [19.0, 8.0];

// Center the taller 247 mm fixture plate inside the 328 mm clear height while
// preserving its measured webcam datum. The carrier then shares that optical
// axis and retains even more vertical service margin.
optical_datum_z = gantry_clear_z_min +
                  (frame_clear.z - fixture_plate_size.y) / 2 +
                  fixture_webcam_datum.y;
optical_datum = [frame_outer.x / 2, optical_datum_z]; // [X, Z]
plate_mount_gap = 5.0;

// Direction contract—do not translate "front/back" into coordinates:
//   Y=0             = human/operator-side outer frame plane
//   increasing Y    = toward the DUT and wall
//   Y=frame_outer.y = wall-side outer frame plane
//
// The electronics/webcam gantry is intentionally advanced 45 mm wallward from
// its legal human-side stop. This leaves a real service bay between the
// operator-side rail and the populated board while retaining the complete DUT
// plus more than 10 mm on every edge in the conservative C270 model. The
// movable gantry remains the camera-distance adjustment; the DUT carrier stays
// fixed to the wall-side frame.
fixture_default_gantry_y = 75.0;
fixture_gantry_y = fixture_default_gantry_y;
fixture_bar_y = fixture_gantry_y;
rear_carrier_rail_y = frame_outer.y - profile_size / 2;
rear_carrier_service_gap = profile_size + plate_mount_gap;

// Moving the fixture gantry changes camera distance without changing the
// fixed carrier or its optical registration.
fixture_plane_y = fixture_gantry_y - profile_size / 2 - plate_mount_gap;
fixture_origin = [optical_datum.x - fixture_webcam_datum.x,
                  fixture_plane_y,
                  optical_datum.y - fixture_webcam_datum.y];
human_side_inner_face_y = profile_size;
fixture_human_service_depth =
    fixture_plane_y - fixture_plate_size.z - human_side_inner_face_y;

// The DUT carrier's hooks/device face -Y toward the webcam and human side.
cradle_plane_y = frame_outer.y - rear_carrier_service_gap;
cradle_origin = [optical_datum.x - cradle_screen_datum.x,
                 cradle_plane_y,
                 optical_datum.y - cradle_screen_datum.y];

fixture_crossbar_z = [fixture_origin.z + fixture_slot_inset.y,
                      fixture_origin.z + fixture_plate_size.y -
                      fixture_slot_inset.y];
fixture_mount_x = [fixture_origin.x + fixture_slot_inset.x,
                   fixture_origin.x + fixture_plate_size.x -
                   fixture_slot_inset.x];
cradle_mount_x = [cradle_origin.x + cradle_slot_inset.x,
                  cradle_origin.x + cradle_plate_size.x -
                  cradle_slot_inset.x];
cradle_mount_z = [cradle_origin.z + cradle_slot_inset.y,
                  cradle_origin.z + cradle_plate_size.y -
                  cradle_slot_inset.y];

// Camera/device preview values.  The mounted C270 keep-out was measured on the
// fixture; Logitech's full clip envelope is larger and is documented in the
// README.  The current C270 product specification gives a conservative 55
// degree diagonal FOV for widescreen capture, from which H/V FOV are derived.
camera_model = "Logitech C270 HD";
camera_installed_keepout = [71.0, 24.0, 31.55]; // [X width, Y depth, Z height]
camera_body_centre_offset_x = 71.0 / 2 - 19.20;
camera_lens_y = fixture_plane_y + 15.0;
camera_diagonal_fov = 55.0;
camera_capture_aspect = [16.0, 9.0];
camera_aspect_diagonal = sqrt(pow(camera_capture_aspect.x, 2) +
                              pow(camera_capture_aspect.y, 2));
camera_assumed_hfov =
    2 * atan(tan(camera_diagonal_fov / 2) * camera_capture_aspect.x /
             camera_aspect_diagonal);
camera_assumed_vfov =
    2 * atan(tan(camera_diagonal_fov / 2) * camera_capture_aspect.y /
             camera_aspect_diagonal);
device_body = EXAMPLE_DEVICE_VARIANT == "trimui_brick" ?
              [72.8, 110.75, 20.0] :
              EXAMPLE_DEVICE_VARIANT == "powkiddy_x55" ?
              [210.0, 88.76, 19.0] : [188.35, 79.77, 10.7];
device_rear_gap = EXAMPLE_DEVICE_VARIANT == "trimui_brick" ||
                  EXAMPLE_DEVICE_VARIANT == "powkiddy_x55" ? 10.0 : 11.0;
// Screen-centered Brick placement leaves its taller shell 28.875 mm below
// the optical axis. Pro-family screens remain centered in their shell proxy.
device_body_offset_from_optical =
    EXAMPLE_DEVICE_VARIANT == "trimui_brick" ? [0.0, -28.875] :
    EXAMPLE_DEVICE_VARIANT == "powkiddy_x55" ? [0.0, -1.0] : [0.0, 0.0];
device_screen_y = cradle_plane_y - device_rear_gap - device_body.z;
optical_distance = device_screen_y - camera_lens_y;
// Pro-family framing covers the complete device body. The taller Brick is
// deliberately screen-centered by its fixture contract; a C270 cannot cover
// its complete asymmetric shell at this distance, so its hard automated
// target is the measured active display. Whole-device composition remains a
// named physical/webcam acceptance gate. Ten millimetres is the asserted
// margin around the selected target.
framing_margin = [10.0, 10.0];
camera_framing_body = EXAMPLE_DEVICE_VARIANT == "trimui_brick" ?
                      [65.02, 48.77] :
                      EXAMPLE_DEVICE_VARIANT == "powkiddy_x55" ?
                      [139.7 * 16 / sqrt(337),
                       139.7 * 9 / sqrt(337)] :
                      [device_body.x, device_body.y];
camera_framing_offset = EXAMPLE_DEVICE_VARIANT == "trimui_brick" ?
                        [0.0, 0.0] :
                        EXAMPLE_DEVICE_VARIANT == "powkiddy_x55" ?
                        [0.0, 0.0] : device_body_offset_from_optical;
framing_target = [camera_framing_body.x +
                      2 * (framing_margin.x +
                           abs(camera_framing_offset.x)),
                  camera_framing_body.y +
                      2 * (framing_margin.y +
                           abs(camera_framing_offset.y))];
required_hfov = 2 * atan((framing_target.x / 2) / optical_distance);
required_vfov = 2 * atan((framing_target.y / 2) / optical_distance);
camera_coverage = [2 * optical_distance * tan(camera_assumed_hfov / 2),
                   2 * optical_distance * tan(camera_assumed_vfov / 2)];
camera_edge_margin = [
    (camera_coverage.x - device_body.x) / 2 -
        abs(device_body_offset_from_optical.x),
    (camera_coverage.y - device_body.y) / 2 -
        abs(device_body_offset_from_optical.y)
];

// ---- Printable interface parameters -------------------------------------
m3_clearance = 3.6;
m5_clearance = 5.5;
spacer_size = [18.0, 14.0];
spacer_corner_radius = 2.0;
plate_spacer_thickness = plate_mount_gap;

// Four broad-face-down ABS links fix the carrier to the wall-side outer width
// rails. Two upper links carry the light plate; two lower links prevent swing
// and racking. A round, keyed rail hole is the dimensional datum. The carrier
// end has 10 mm of vertical adjustment and clamps through the carrier's
// existing corner slot with an ordinary metal M3 nut and wide washers.
rear_carrier_link_width = 18.0;
rear_carrier_link_end_margin =
    CARRIER_LINK_REVISION == "stack_clear_v2" ? 9.0 : 12.0;
rear_carrier_link_thickness =
    (rear_carrier_rail_y - profile_size / 2) - cradle_plane_y;
rear_carrier_link_adjustment = 10.0;
rear_carrier_link_key_length = 12.0;
rear_carrier_bottom_span = cradle_mount_z.x - outer_rail_z.x;
rear_carrier_top_span = outer_rail_z.y - cradle_mount_z.y;
rear_carrier_bottom_length = rear_carrier_bottom_span +
                             2 * rear_carrier_link_end_margin;
rear_carrier_top_length = rear_carrier_top_span +
                          2 * rear_carrier_link_end_margin;

// Pro S dual-bar fixture suspension. The plate is centered vertically
// between the upper/lower outer rails, so every existing plate slot is
// exactly 58.5 mm from its corresponding fixture-bar center. Four identical
// short links can serve all four corners. Each link prints broad-face-down,
// carries a keyed round rail hole, and clamps through one unchanged plate
// slot with an ordinary metal fastener and wide washers.
dualbar_link_width = 22.0;
dualbar_link_end_margin = 6.5;
dualbar_link_corner_radius = 3.0;
dualbar_link_thickness = plate_mount_gap;
dualbar_link_key_length = 16.0;
dualbar_link_spans = [
    fixture_crossbar_z.x - fixture_bar_z.x,
    fixture_bar_z.y - fixture_crossbar_z.y
];
dualbar_link_span = dualbar_link_spans.x;
dualbar_link_length =
    dualbar_link_span + 2 * dualbar_link_end_margin;
dualbar_link_batch_gap = 6.0;
dualbar_link_set_size = [
    2 * dualbar_link_width + dualbar_link_batch_gap,
    2 * dualbar_link_length + dualbar_link_batch_gap
];

// Owner-accepted dual USB-C interrupter holder. Its installed X datum is
// derived from the left upper fixture-link edge, retaining an exact 5 mm
// service gap rather than freezing a scene-specific absolute coordinate.
usbci_fixture_link_edge_gap = 5.0;
usbci_mount_center_x = fixture_mount_x.x + dualbar_link_width / 2 +
                       usbci_fixture_link_edge_gap +
                       usbci_mount_pad_size().x / 2;
usbci_face_center_z = fixture_bar_z.y - profile_size / 2 - 8.0;
usbci_rail_contact_y = fixture_bar_y - profile_size / 2;
usbci_installed_edge_gap = usbci_mount_center_x -
                           usbci_mount_pad_size().x / 2 -
                           (fixture_mount_x.x + dualbar_link_width / 2);
usbci_lower_face_z = usbci_face_center_z +
                     min(usbci_face_row_centres()) -
                     usbci_face_size().y / 2;
usbci_fixture_top_z = fixture_origin.z + fixture_plate_size.y;
usbci_operator_service_depth = usbci_rail_contact_y -
                               usbci_retention_depth() -
                               human_side_inner_face_y;
usbci_stack_top_z = usbci_face_center_z +
                    usbci_mount_pad_centre_y() +
                    usbci_mount_pad_size().y / 2;

// Six outer-width-rail locations remain active. Four power-strip locations
// move to the lower operator-right depth rail. The keyed fixture links add two
// active locations per fixture bar, while four printed crossbar joints add two
// more per fixture bar and one to each depth rail. Four depth-rail spares and
// one spare in each fixture bar remain parked before the rail ends close.
dualbar_m3_slide_nut_required_count = 22;
dualbar_m3_slide_nut_spare_count = 6;
dualbar_m3_slide_nut_set_count =
    dualbar_m3_slide_nut_required_count + dualbar_m3_slide_nut_spare_count;
// Physical ABS coupon result with the lab's 0.8 mm nozzle: 6.43 mm slides
// cleanly; 6.63 mm is too large and 6.23 mm is the loose snap-in fallback.
slot_key_clearance = 0.30;
slot_key_width = extrusion_slot_opening - slot_key_clearance;
slot_key_height = 1.2;

// Ordinary metal M3 nut captured inside a large, end-loaded ABS nut bar.  The
// 5.6 x 2.8 mm pocket is the already print-validated DUT-hook fit for the
// owner's measured 5.36 x 2.30 mm nuts.  Unlike the retired twist-in carrier,
// this body is deliberately too wide to pass through the slot mouth: slide it
// into the open end of an extrusion before the frame end is assembled.  Its
// broad bearing face nearly fills the measured 12.15 mm under-lip pocket and
// tapers toward the extrusion web, following the delivered rail's channel
// instead of inheriting a narrow commercial T-nut envelope.
m3_nut_measured_across_flats = 5.36;
m3_nut_measured_thickness = 2.30;
m3_nut_pocket_across_flats = 5.60;
m3_nut_pocket_depth = 2.80;
// Keep the single-nut carrier inside the 20 mm fixture-upright landing
// envelope. The earlier 30/60 mm handling-bar experiments protruded beyond
// that interface and physically interfered during the owner walkthrough.
m3_slide_nut_length = 18.0;
m3_slide_nut_bearing_width = 11.75;
// Owner physically accepted both pass-3 bars on 2026-07-22. The wider,
// two-scallop 6.46 mm candidate is the production profile because it retains
// the most bearing material while still travelling freely in the real rail.
m3_slide_nut_deep_width = 6.46;
m3_slide_nut_height = 4.40;
m3_slide_nut_flange_height = 0.40;
m3_slide_nut_corner_chamfer = 3.0;
// Third physical pass: the 11.75 mm bearing face reaches the under-lip pocket,
// but the shared 8.90 mm deep face collided with the rail and its delayed
// taper did not follow the channel.  F measures 6.66 mm; the two candidates
// bracket the same -0.30 mm process compensation selected by the rail coupon.
m3_slide_nut_coupon_deep_widths = [6.26, 6.46];
m3_slide_nut_coupon_copies = 1;
m3_slide_nut_required_count = 22; // includes 4 right-depth power-strip mounts
m3_slide_nut_spare_count = 6;     // pre-load before rail ends are closed
m3_slide_nut_set_count = m3_slide_nut_required_count +
                         m3_slide_nut_spare_count;
m3_slide_nut_set_columns = 4;

function m3_slide_nut_width_at_height(
    z,
    bearing_width = m3_slide_nut_bearing_width,
    deep_width = m3_slide_nut_deep_width
) = z <= m3_slide_nut_flange_height ? bearing_width :
    bearing_width + (deep_width - bearing_width) *
    ((z - m3_slide_nut_flange_height) /
     (m3_slide_nut_height - m3_slide_nut_flange_height));

// Two non-structural fixture-gantry uprights are each made from two 164 mm
// stock-plan segments. One accepted full-wrap collar plus two long,
// channel-matched internal bars aligns each central butt joint. The owner
// physically validated the 0.20 mm collar clearance, self-indexing pusher, and
// corrected asymmetric bars. Each bar captures one metal M3 nut in each rail
// half, so the collar and opposed internal bars bridge the joint without
// drilling aluminum.
gantry_splice_length = 80.0;
gantry_splice_wall = 4.8;
gantry_splice_external_clearance = 0.20;
gantry_splice_inner_width = profile_size +
                             gantry_splice_external_clearance;
gantry_splice_fastener_x = 24.0;
gantry_splice_internal_bar_length = 80.0;
gantry_splice_internal_nut_x = [-gantry_splice_fastener_x,
                                 gantry_splice_fastener_x];
gantry_splice_internal_bar_count = 4; // two opposed bars x two uprights
gantry_splice_collar_hole_diameter = 4.2;
gantry_splice_collar_corner_relief = 2.4;
gantry_splice_collar_entry_relief = 0.8;
gantry_splice_collar_entry_depth = 1.2;
// Two opposed keys at the collar's trailing end act as a moving depth stop.
// Dimensions are multiples of the lab's 0.8 mm nozzle where practical.  The
// narrowed 1.6 mm lead-in avoids first-layer elephant-foot binding, while the
// full 6.43 mm section reuses the physically accepted slot-key fit.
gantry_splice_collar_pusher_length = 3.2;
gantry_splice_collar_pusher_depth = 2.4;
gantry_splice_collar_pusher_lead = 1.6;
gantry_splice_collar_pusher_tip_inset = 0.8;
// The pusher occupies the first 3.2 mm of the collar/rail span. A regular
// 80 mm bar therefore protrudes 3.2 mm into the rail butt joint and its holes
// cannot align. The collar-specific bar removes exactly that material from
// its pusher end while retaining the collar's established +/-24 mm hole
// datums. Its geometric center consequently sits 1.6 mm toward rail B.
gantry_splice_collar_internal_bar_length =
    gantry_splice_internal_bar_length - gantry_splice_collar_pusher_length;
gantry_splice_collar_internal_bar_center_offset =
    gantry_splice_collar_pusher_length / 2;
gantry_splice_collar_internal_nut_x =
    [for (x = gantry_splice_internal_nut_x)
        x - gantry_splice_collar_internal_bar_center_offset];

// One identical flat ABS indexing plate locates every gantry-upright endpoint
// against an outer depth rail.  Perpendicular rear keys enter the two slots to
// square the joint; ordinary M3 screws and captured metal nuts provide clamp
// force.  These light-duty plates position payload gantries only and never
// enter the outer-frame or stacking load path.
// The plate bridges rail centerlines 20 mm apart. Its former 44 mm long
// dimension projected 2 mm beyond the outer aluminum plane at both the lower
// and upper legacy-gantry joints. Keep one 0.8 mm nozzle width inboard at each
// end so neighboring chassis can sit directly side by side despite ordinary
// print-edge tolerance.
gantry_joint_flush_span = 2 * profile_size;
gantry_joint_side_inset = 0.8;
gantry_joint_plate_size = [36.0,
                           GANTRY_JOINT_REVISION == "side_clear_v2" ?
                               gantry_joint_flush_span -
                                   2 * gantry_joint_side_inset : 44.0,
                           4.8];
usbci_left_joint_max_x = profile_size + profile_size / 2 +
                         gantry_joint_plate_size.y / 2;
usbci_right_joint_min_x = frame_outer.x - profile_size -
                          profile_size / 2 -
                          gantry_joint_plate_size.y / 2;
gantry_joint_corner_radius = 3.0;
gantry_joint_hole_offset = 10.0;
gantry_joint_slot = [8.0, m3_clearance];
gantry_joint_key_length = 18.0;
gantry_joint_key_height = slot_key_height;

// Reusable fleet ID system. A 230 mm holder is the largest clean standard that
// fits the conservative 247 mm Prusa X envelope. Only the cartridge changes with
// the DUT. Long labels shrink deterministically; ordinary names retain the
// coarse-nozzle-proven 13.5 mm text instead of being stretched to fill space.
placard_size = [230.0, 38.0, 7.0];
placard_corner_radius = 4.0;
placard_hole_spacing = 190.0;
placard_text_nominal_size = 13.5;
placard_text_minimum_size = 8.5;
placard_text_horizontal_margin = 10.0;
placard_text_width_factor = 0.78;
placard_text_relief = 1.2;
placard_holder_base_thickness = 3.2;
placard_holder_rail_height = 3.8;
placard_holder_rail_lower_inner = 15.0;
placard_holder_rail_upper_inner = 13.2;
placard_holder_end_stop = 3.2;
placard_holder_rail_end_inset = placard_corner_radius;
placard_mount_countersink_diameter = 7.0;
placard_mount_countersink_depth = 2.2;
placard_insert_thickness = 2.4;
placard_insert_base_width = 29.0;
placard_insert_top_width = 25.6;
placard_insert_body_length = placard_size.x -
                             2 * placard_holder_rail_end_inset -
                             placard_holder_end_stop - 0.4;
placard_insert_body_center_x = placard_holder_end_stop / 2;
placard_insert_tab_size = [12.0, 12.0];
placard_insert_tab_overlap = 2.0;
placard_insert_pull_hole_diameter = 4.0;
placard_holder_color = [0.16, 0.28, 0.42];
placard_insert_color = [0.96, 0.96, 0.93];
// Match the rear carrier's dark raised-label treatment. The printable insert
// remains one fused mesh; this split exists only at presentation boundaries.
placard_label_color = [0.02, 0.02, 0.02];
placard_spacer_thickness = 3.0;
placard_riser_size = [18.0, 58.0, 4.0];
placard_riser_hole_offset = 18.0;
placard_riser_slot = [10.0, m3_clearance];
placard_rail_mount_z = outer_rail_z.y;
placard_center_z = placard_rail_mount_z -
                   2 * placard_riser_hole_offset;
placard_riser_center_z = (placard_rail_mount_z + placard_center_z) / 2;

// ---- Inboard operator-right lower-depth-rail power-strip interface -------
// Viewed from the operator side, the strip runs front-to-back along the
// INSIDE face of the lower right depth rail. Its long axis follows Y, its
// measured 48.5 mm short axis stays below the fixture board, and its
// preview-only enclosure depth projects -X into the chassis. The device-ward
// bias clears the movable fixture-bar connector while keeping both blocks
// inside the two right corner posts.
//
// Two independently sliding blocks avoid treating the unmeasured long-axis
// keyhole pitch as authoritative. Each block accepts two of the strip's four
// supplied mounting screws at the measured symmetric 27.6 mm transverse pitch.
power_strip_length = 204.27;
power_strip_enclosure_depth = 32.0; // preview-only side-profile depth
power_strip_height = 48.5;
power_strip_body_size = [power_strip_enclosure_depth,
                         power_strip_length,
                         power_strip_height]; // world X, Y, Z
power_strip_body_depth_is_preview_only = true;
power_strip_cable_keepout = [36.0, 36.0, 14.0];
power_strip_bottom_z = 0.0;
power_strip_keyhole_bore = 3.3;
power_strip_keyhole_head = 5.5;
power_strip_small_hole_diameter = 3.4;
// Owner measured 31 mm from the far outside edges of the two 3.4 mm holes.
power_strip_small_hole_centres = 31.0 - power_strip_small_hole_diameter;
// This is a drill-start guide, not a final thread-size promise. Start with the
// printed 2 mm pilot and enlarge only if the supplied screw's root diameter or
// insertion torque requires it. The 10 mm blind depth leaves 3 mm of ABS
// between the screw and the extrusion.
power_strip_screw_pilot_diameter = 2.0;
power_strip_screw_pilot_depth = 10.0;
power_strip_screw_pilot_entry_diameter = 3.2;
power_strip_screw_pilot_entry_depth = 1.2;
// Local block X becomes installed world Z; local Y becomes world Y; local Z
// points inward along world -X. Retaining the 54 x 40 x 13 mm printed
// envelope therefore yields a 40 mm long, 54 mm tall block on the lower
// operator-right depth rail.
power_strip_mount_plate_size = [54.0, 40.0, 13.0];
power_strip_inside_rail_face_x = frame_outer.x - profile_size;
power_strip_mount_face_x =
    power_strip_inside_rail_face_x - power_strip_mount_plate_size.z;
power_strip_body_left_x =
    power_strip_mount_face_x - power_strip_body_size.x;
power_strip_mount_block_center_z = power_strip_mount_plate_size.x / 2;
// The rail slot center is Z=10. The strip's transverse hole pair is centered
// on its measured 48.5 mm body, not on the slightly taller 54 mm ABS block.
power_strip_rail_center_offset =
    profile_size / 2 - power_strip_mount_block_center_z;
power_strip_screw_row_center_offset =
    power_strip_body_size.z / 2 - power_strip_mount_block_center_z;
power_strip_rail_hole_pitch = 24.0;
power_strip_rail_countersink_diameter = 6.4;
power_strip_rail_countersink_depth = 1.8;
power_strip_end_keyhole_inset = 12.0; // assembly-preview only; blocks slide
// Leave enough device-side rail for the 40 mm block to stop before the corner
// post. The resulting operator-side block also clears the Y=75 fixture joint.
power_strip_device_y =
    frame_outer.y - profile_size -
    (power_strip_mount_plate_size.y / 2 - power_strip_end_keyhole_inset);
power_strip_operator_y = power_strip_device_y - power_strip_body_size.y;
power_strip_block_y =
    [power_strip_operator_y + power_strip_end_keyhole_inset,
     power_strip_device_y - power_strip_end_keyhole_inset];
power_strip_rail_fastener_y =
    [for (block_y = power_strip_block_y)
         for (offset = [-power_strip_rail_hole_pitch / 2,
                         power_strip_rail_hole_pitch / 2])
             block_y + offset];
power_strip_cable_left_x =
    power_strip_body_left_x +
    (power_strip_body_size.x - power_strip_cable_keepout.x) / 2;
power_strip_cable_operator_y =
    power_strip_operator_y - power_strip_cable_keepout.y;
power_strip_pilot_coupon_diameters = [1.6, 1.8, 2.0];
power_strip_coupon_base_thickness = 8.0;
power_strip_pilot_coupon_depth = 6.0;
power_strip_pilot_coupon_size = [18.0, 18.0];
power_strip_coupon_corner_radius = 2.0;
power_strip_coupon_witness_diameter = 3.2;
power_strip_coupon_witness_pitch = 4.0;
// Preview-only representation of one of the strip's supplied screws.
power_strip_supplied_screw_shank_diameter =
    min(3.0, power_strip_keyhole_bore - 0.3);
power_strip_coupon_stud_head_diameter = power_strip_keyhole_head - 0.3;
power_strip_coupon_stud_head_height = 2.4;
power_strip_supplied_screw_head_gap = 1.6;

function placard_fitted_text_size(label_text) =
    min(placard_text_nominal_size,
        (placard_insert_body_length -
         2 * placard_text_horizontal_margin) /
        (max(1, len(label_text)) * placard_text_width_factor));

// Broad, uninterrupted top surfaces for slicer ironing calibration. Six
// disconnected coupons keep a small ABS job thermally well behaved and may be
// split into objects for per-object slicer overrides. Semicircular edge marks
// identify coupons 1..6 without changing the surface being evaluated.
ironing_coupon_size = [45.0, 30.0, 3.2];
ironing_coupon_corner_radius = 3.0;
ironing_coupon_notch_diameter = 3.2;
ironing_coupon_notch_pitch = 4.0;
ironing_coupon_columns = 3;
ironing_coupon_rows = 2;
ironing_coupon_gap = [10.0, 10.0];
ironing_coupon_count = ironing_coupon_columns * ironing_coupon_rows;

// Each corner gets two non-load-bearing registration tabs.  The 18 mm width
// leaves 1 mm of visible aluminum on either side of a 20 mm rail face.  The
// lower 60 mm preserves the established lower-chassis screw datums; the upper
// 32 mm spans the complete bottom rail of the next chassis and continues
// 12 mm beside its post for a generous lead-in.
registration_lower_engagement = 60.0;
registration_above_frame = 32.0;
registration_tab_size = [
    18.0,
    registration_lower_engagement + registration_above_frame,
    4.0
];
registration_lower_slot = [9.0, m5_clearance];
registration_lower_hole_y = [12.0, 28.0];
// The delivered dual-bar metal corner extends across the former rail-groove
// datum. Lift that candidate's upper fastening hole 7 mm while preserving the
// immutable geometry of the physically qualified legacy chassis pack.
registration_upper_lock_corner_clearance =
    CHASSIS_VARIANT == "dualbar_v1" ? 7.0 : 0.0;
registration_upper_lock_y =
    registration_lower_engagement + profile_size / 2 +
        registration_upper_lock_corner_clearance;
registration_tab_count = 8;
registration_tab_columns = 4;
registration_tab_gap = [6.0, 6.0];
registration_tab_pitch = [
    registration_tab_size.x + registration_tab_gap.x,
    registration_tab_size.y + registration_tab_gap.y
];
registration_tab_rows =
    ceil(registration_tab_count / registration_tab_columns);
registration_tab_set_size = [
    (registration_tab_columns - 1) * registration_tab_pitch.x +
        registration_tab_size.x,
    (registration_tab_rows - 1) * registration_tab_pitch.y +
        registration_tab_size.y,
    registration_tab_size.z
];

// Repositionable, non-structural cable anchors bolt to any exposed 2020 rail
// face with one M5 or M3 drop-in T-nut. Two transverse tunnels keep an ordinary zip
// tie entirely outside the aluminum slot and let a builder use either one tie
// or two without changing the part. The tunnel contract accepts common ties
// up to 4.8 mm wide x 1.6 mm thick. Every wall/roof dimension is a multiple of
// the lab's 0.8 mm nozzle where practical, and the 5.6 mm bridge span prints
// broad-face-down without support.
cable_anchor_count = 8;
cable_anchor_size = [32.0, 18.0];
cable_anchor_corner_radius = 2.4;
cable_anchor_base_thickness = 4.8;
cable_anchor_tie_max_width = 4.8;
cable_anchor_tie_max_thickness = 1.6;
cable_anchor_tie_passage = [5.6, 2.4]; // [tie width, tie thickness]
cable_anchor_passage_radius = 0.6;
cable_anchor_entry_flare = 0.4;
cable_anchor_bridge_wall = 1.6;
cable_anchor_bridge_roof = 1.6;
cable_anchor_bridge_width =
    cable_anchor_tie_passage.x + 2 * cable_anchor_bridge_wall;
cable_anchor_bridge_centres = [-9.6, 9.6];
cable_anchor_total_height = cable_anchor_base_thickness +
                            cable_anchor_tie_passage.y +
                            cable_anchor_bridge_roof;
CABLE_ANCHOR_FASTENER = "M5"; // [M5, M3]
cable_anchor_fastener_clearance =
    CABLE_ANCHOR_FASTENER == "M5" ? m5_clearance : m3_clearance;
cable_anchor_washer_diameter =
    CABLE_ANCHOR_FASTENER == "M5" ? 10.0 : 7.0;
cable_anchor_head_stack =
    CABLE_ANCHOR_FASTENER == "M5" ? 3.8 : 3.2;
cable_anchor_batch_columns = 4;
cable_anchor_batch_pitch = [40.0, 28.0];
cable_anchor_batch_origin = [18.0, 12.0];

// ---- Derived-fit guards --------------------------------------------------
// The axis swap intentionally accepts 29.5 mm on each side of the widest
// 247 mm carrier so every finished outer-frame rail can be reused.
minimum_routing_margin = 29.0;
inner_min = [profile_size, gantry_clear_z_min];
inner_max = [frame_outer.x - profile_size,
             gantry_clear_z_max];
fixture_margins = [fixture_origin.x - inner_min.x,
                   inner_max.x - (fixture_origin.x + fixture_plate_size.x),
                   fixture_origin.z - inner_min.y,
                   inner_max.y - (fixture_origin.z + fixture_plate_size.y)];
cradle_margins = [cradle_origin.x - inner_min.x,
                  inner_max.x - (cradle_origin.x + cradle_plate_size.x),
                  cradle_origin.z - inner_min.y,
                  inner_max.y - (cradle_origin.z + cradle_plate_size.y)];

assert(EXAMPLE_DEVICE_VARIANT == "smart_pro" ||
       EXAMPLE_DEVICE_VARIANT == "smart_pro_s" ||
       EXAMPLE_DEVICE_VARIANT == "trimui_brick" ||
       EXAMPLE_DEVICE_VARIANT == "powkiddy_x55",
       str("Unknown example device variant: ", EXAMPLE_DEVICE_VARIANT));
assert(CHASSIS_VARIANT == "legacy_gantry" ||
       CHASSIS_VARIANT == "dualbar_v1",
       str("Unknown chassis variant: ", CHASSIS_VARIANT));
assert(CARRIER_LINK_REVISION == "legacy_v1" ||
       CARRIER_LINK_REVISION == "stack_clear_v2",
       str("Unknown carrier-link revision: ", CARRIER_LINK_REVISION));
assert(GANTRY_JOINT_REVISION == "overhang_v1" ||
       GANTRY_JOINT_REVISION == "side_clear_v2",
       str("Unknown gantry-joint revision: ", GANTRY_JOINT_REVISION));
assert(frame_outer == [structural_x_length + 2 * profile_size,
                       structural_y_length + 2 * profile_size,
                       structural_z_length +
                           2 * connector_end_overhang],
       "Frame envelope must derive from the measured cap-and-side-butt joint");
assert(outer_rail_z.x - profile_size / 2 == 0 &&
       outer_rail_z.y + profile_size / 2 == frame_outer.z,
       "Horizontal rail outer faces must be flush with both connector caps");
assert(min(fixture_margins) >= minimum_routing_margin,
       str("Fixture routing margin fell below ", minimum_routing_margin,
           " mm: ", fixture_margins));
assert(min(cradle_margins) >= minimum_routing_margin,
       str("Cradle routing margin fell below ", minimum_routing_margin,
           " mm: ", cradle_margins));
assert(fixture_gantry_y >= gantry_y_limits.x &&
       fixture_gantry_y <= gantry_y_limits.y,
       str("Fixture gantry Y is outside legal travel: ", fixture_gantry_y));
assert(fixture_bar_y >= gantry_y_limits.x &&
       fixture_bar_y <= gantry_y_limits.y,
       str("Fixture-bar Y is outside legal travel: ",
           fixture_bar_y));
assert(fixture_plane_y - fixture_plate_size.z >= 0,
       "Fixture board must not project beyond the human-side frame plane");
assert(fixture_human_service_depth >= 30.0,
       str("Fixture board must leave at least 30 mm of human-side service bay; ",
           "actual ", fixture_human_service_depth, " mm"));
assert((rear_carrier_rail_y - profile_size / 2) - cradle_plane_y ==
       rear_carrier_link_thickness,
       "Rear carrier links must bridge the derived rail-to-plate depth");
assert(frame_outer.y - cradle_plane_y == rear_carrier_service_gap,
       "Rear carrier must retain the declared wall-side mounting offset");
assert(rear_carrier_link_thickness >= plate_mount_gap,
       "Wall-mounted rear carrier still needs a positive rail bridge");
assert(CARRIER_LINK_REVISION != "stack_clear_v2" ||
       (outer_rail_z.x - rear_carrier_link_end_margin >= 1.0 &&
        outer_rail_z.y + rear_carrier_link_end_margin <=
            frame_outer.z - 1.0),
       "Stack-clear carrier links must stay at least 1 mm inside both chassis planes");
assert(gantry_upright_segment_count == 2 &&
       2 * gantry_upright_segment_length == gantry_upright_length,
       "Each movable gantry upright must be two equal offcut segments");
assert(fixture_bar_length == structural_x_length &&
       fixture_bar_z == outer_rail_z,
       "Dual-bar variant must use standard-width rails at both outer datums");
assert(fixture_bar_y - profile_size / 2 -
           dualbar_link_thickness == fixture_plane_y,
       "Dual-bar links must preserve the proven fixture plate plane");
assert(legacy_fixture_extrusion == 1268.0 &&
       dualbar_fixture_extrusion == 612.0 &&
       dualbar_extrusion_savings == 656.0,
       "Dual-bar material delta must remain 1268 - 612 = 656 mm");
assert(gantry_splice_length < gantry_upright_segment_length,
       "Upright splice must leave exposed aluminum on both segments");
assert(min([for (z = fixture_crossbar_z)
                abs(z - gantry_upright_splice_z)]) >=
       gantry_splice_length / 2 + profile_size / 2,
       "Central upright splice must not collide with a plate crossbar");
assert(min(fixture_crossbar_z) >= gantry_clear_z_min + profile_size / 2 &&
       max(fixture_crossbar_z) <= gantry_clear_z_max - profile_size / 2,
       str("Fixture crossbar Z is outside gantry travel: ",
           fixture_crossbar_z));
assert(rear_carrier_bottom_span > rear_carrier_link_adjustment &&
       rear_carrier_top_span > rear_carrier_link_adjustment,
       "Rear carrier links need positive spans beyond their adjustment slots");
assert(rear_carrier_link_key_length > m3_clearance &&
       slot_key_width > m3_clearance,
       "Rear carrier rail key must retain printable material around M3");
assert(min(dualbar_link_spans) > 0 &&
       dualbar_link_spans.x == dualbar_link_spans.y,
       str("Upper/lower fixture-link spans must be positive and symmetric: ",
           dualbar_link_spans));
assert(dualbar_link_span == 58.5 &&
       dualbar_link_length == 71.5,
       "Dual-bar fixture links must stay derived from the frozen rail/slot datums");
assert(dualbar_link_key_length > m3_clearance &&
       dualbar_link_key_length <= dualbar_link_width - 4.0,
       "Dual-bar rail key must retain printable side walls");
assert(dualbar_link_end_margin >= m3_clearance / 2 + 4.0,
       "Dual-bar links need at least 4 mm beyond each M3 hole");
assert(dualbar_link_set_size.x <= 247.0 &&
       dualbar_link_set_size.y <= 207.0,
       str("Four-link dual-bar batch must fit the 247 x 207 mm print bed: ",
           dualbar_link_set_size));
assert(abs(usbci_mount_center_x - 136.7) < 0.001,
       str("USB-C interrupter derived center changed: ",
           usbci_mount_center_x));
assert(abs(usbci_installed_edge_gap - 5.0) < 0.001,
       str("USB-C interrupter must remain exactly 5 mm right of the left upper fixture link; actual ",
           usbci_installed_edge_gap, " mm"));
assert(usbci_lower_face_z - usbci_fixture_top_z >= 20.0,
       "USB-C interrupter must clear fixture plate and components vertically");
assert(usbci_operator_service_depth >= 30.0,
       "Both USB-C receptacles need an unobstructed operator-side cable bay");
assert(usbci_mount_center_x + usbci_mount_pad_size().x / 2 <
       fixture_mount_x.y - dualbar_link_width / 2,
       "USB-C interrupter must clear the adjacent fixture link");
assert(usbci_mount_center_x - usbci_mount_pad_size().x / 2 >=
           usbci_left_joint_max_x + 3.0 &&
       usbci_mount_center_x + usbci_mount_pad_size().x / 2 <=
           usbci_right_joint_min_x - 3.0,
       "USB-C interrupter must clear both fixture-bar joint plates by 3 mm");
assert(usbci_rail_contact_y < camera_lens_y,
       "USB-C interrupter must remain operator-side of the camera/frustum");
assert(usbci_rail_contact_y < cradle_plane_y - device_rear_gap - device_body.z,
       "USB-C interrupter must clear the carrier and DUT envelope");
assert(usbci_mount_center_x - usbci_mount_pad_size().x / 2 >= profile_size &&
       usbci_mount_center_x + usbci_mount_pad_size().x / 2 <=
           frame_outer.x - profile_size &&
       usbci_stack_top_z <= frame_outer.z,
       "USB-C interrupter must remain inside the chassis stacking envelope");
assert(min(fixture_mount_x) -
           dualbar_link_width / 2 >= profile_size &&
       max(fixture_mount_x) +
           dualbar_link_width / 2 <=
               frame_outer.x - profile_size,
       "Dual-bar links must land on both continuous fixture-bar spans");
assert(fixture_crossbar_z.x - dualbar_link_end_margin >
           fixture_bar_z.x + profile_size / 2 &&
       fixture_crossbar_z.y + dualbar_link_end_margin <
           fixture_bar_z.y - profile_size / 2,
       "Fixture slots need clear link material between both bars and plate");
assert(dualbar_m3_slide_nut_required_count == 22 &&
       dualbar_m3_slide_nut_spare_count == 6 &&
       dualbar_m3_slide_nut_set_count == 28,
       "Dual-bar preload contract must remain 22 active plus 6 parked bars");
assert(optical_distance > 0, "Camera must remain in front of the DUT");
assert(camera_assumed_hfov >= required_hfov,
       str("Estimated horizontal FOV is too narrow; required ", required_hfov));
assert(camera_assumed_vfov >= required_vfov,
       str("Estimated vertical FOV is too narrow; required ", required_vfov));
assert(slot_key_width > m3_clearance,
       "T-slot key must remain wider than the M3 clearance hole");
assert(m3_nut_pocket_across_flats >= m3_nut_measured_across_flats,
       "M3 nut pocket must not be smaller than the measured nut");
assert(m3_nut_pocket_depth >= m3_nut_measured_thickness,
       "M3 nut pocket must not be shallower than the measured nut");
assert(m3_slide_nut_bearing_width > extrusion_slot_opening,
       "End-loaded carrier bearing face must be wider than the slot mouth");
assert(m3_slide_nut_bearing_width < extrusion_slot_pocket_width,
       "End-loaded carrier bearing face must fit inside the measured slot pocket");
assert(m3_slide_nut_deep_width >
       m3_nut_pocket_across_flats + 0.5,
       "Deep face must clear the metal nut across flats");
assert(m3_slide_nut_deep_width < extrusion_slot_deep_width,
       "Deep face must clear measured rail dimension F");
assert(m3_slide_nut_deep_width < m3_slide_nut_bearing_width,
       "End-loaded carrier must taper inward away from its bearing face");
assert(min(m3_slide_nut_coupon_deep_widths) >
           m3_nut_pocket_across_flats + 0.5 &&
       max(m3_slide_nut_coupon_deep_widths) < extrusion_slot_deep_width,
       "Every coupon deep face must clear both nut and measured rail");
assert(len(m3_slide_nut_coupon_deep_widths) *
       m3_slide_nut_coupon_copies == 2,
       "Third-pass nut-bar coupon must contain exactly two pieces");
assert(m3_slide_nut_height <
       extrusion_slot_depth - extrusion_slot_lip_depth,
       "End-loaded carrier must fit behind the measured slot lip");
assert(m3_slide_nut_flange_height > 0 &&
       m3_slide_nut_flange_height < m3_slide_nut_height,
       "Nut-bar bearing flange must fit inside its total channel depth");
assert(m3_slide_nut_length >=
       m3_nut_pocket_across_flats + 2 * 3.0,
       "End-loaded carrier must retain 3 mm end walls around the metal nut");
assert(m3_slide_nut_length <= profile_size - 2.0,
       "Short carrier must stay inside the fixture-upright landing envelope");
assert(m3_slide_nut_height - m3_nut_pocket_depth >= 1.6,
       "End-loaded carrier needs at least four 0.4 mm floor layers");
assert(m3_slide_nut_width_at_height(
           m3_slide_nut_height - m3_nut_pocket_depth) >=
       m3_nut_pocket_across_flats + 2 * 1.6,
       "Nut-pocket floor needs two printable side walls");
assert(gantry_splice_inner_width > profile_size,
       "Splice collar needs positive external rail clearance");
assert(gantry_splice_fastener_x + m3_clearance / 2 <
       gantry_splice_length / 2,
       "Splice fasteners must remain inside the collar length");
assert(gantry_splice_internal_bar_length == gantry_splice_length,
       "Base internal splice bar and collar must bridge the same seam");
assert(max([for (x = gantry_splice_internal_nut_x) abs(x)]) +
           m3_nut_pocket_across_flats / 2 <
       gantry_splice_internal_bar_length / 2,
       "Internal splice nuts need printable end walls");
assert(gantry_splice_collar_hole_diameter >= m3_clearance,
       "Horizontally printed collar holes must clear M3 hardware");
assert(gantry_splice_collar_entry_depth > 0 &&
       gantry_splice_collar_entry_depth < gantry_splice_wall,
       "Collar entry relief must remain a shallow lead-in");
assert(gantry_splice_collar_pusher_length >
       gantry_splice_collar_pusher_lead,
       "Collar pusher needs a full-width bearing section after its lead-in");
assert(gantry_splice_collar_pusher_tip_inset > 0 &&
       gantry_splice_collar_pusher_tip_inset < slot_key_width,
       "Collar pusher tip inset must leave a positive lead-in width");
assert(gantry_splice_collar_pusher_depth >
       extrusion_slot_lip_depth +
       gantry_splice_external_clearance / 2,
       "Collar pusher must overlap the internal bar behind the rail lip");
assert(gantry_splice_collar_pusher_depth < extrusion_slot_depth,
       "Collar pusher must remain inside the measured rail channel");
assert(abs(gantry_splice_collar_internal_bar_length +
           gantry_splice_collar_pusher_length - gantry_splice_length) <
           epsilon,
       "Collar pusher plus shortened bar must exactly fill one rail half");
assert(max([for (index = [0 :
                          len(gantry_splice_internal_nut_x) - 1])
                abs(gantry_splice_collar_internal_nut_x[index] +
                    gantry_splice_collar_internal_bar_center_offset -
                    gantry_splice_internal_nut_x[index])]) < epsilon,
       "Shortened collar-bar nuts must remain aligned to collar holes");
assert(gantry_joint_plate_size.x > gantry_joint_key_length &&
       gantry_joint_plate_size.y >
       2 * gantry_joint_hole_offset + gantry_joint_slot.y,
       "Gantry joint plate must surround both keyed fastener interfaces");
assert(GANTRY_JOINT_REVISION != "side_clear_v2" ||
       gantry_joint_plate_size.y <= gantry_joint_flush_span -
                                          2 * gantry_joint_side_inset,
       str("Crossbar joint plate must stay at least ",
           gantry_joint_side_inset,
           " mm inside both outward extrusion planes"));
assert(placard_center_z + placard_size.y / 2 <
       outer_rail_z.y - profile_size / 2,
       "Front placard must remain completely below the top front rail");
assert(placard_size.z == placard_holder_base_thickness +
                          placard_holder_rail_height,
       "Placard holder envelope must equal its base plus rail height");
assert(placard_insert_base_width <
           2 * placard_holder_rail_lower_inner &&
       placard_insert_top_width <
           2 * placard_holder_rail_upper_inner,
       "Placard cartridge needs positive dovetail sliding clearance");
assert(placard_insert_thickness < placard_holder_rail_height,
       "Placard cartridge must fit beneath the retaining rails");
assert(placard_insert_body_length > placard_hole_spacing,
       "Placard cartridge must span both hidden holder fasteners");
assert(placard_fitted_text_size(DEVICE_LABEL) >=
           placard_text_minimum_size,
       "Device label is too long for the fleet placard at minimum text size");
assert(placard_size.x <= 247.0,
       "Fleet placard holder must fit the conservative Prusa X envelope");
assert(max(power_strip_pilot_coupon_diameters) <
           power_strip_small_hole_diameter,
       "Power-strip pilot variants must remain below the supplied screw path");
assert(power_strip_coupon_stud_head_diameter < power_strip_keyhole_head,
       "Power-strip preview screw head must fit the measured keyhole opening");
assert(power_strip_screw_pilot_depth <
           power_strip_mount_plate_size.z,
       "Power-strip screw pilots must stop before the aluminum extrusion");
assert(power_strip_screw_pilot_depth +
           2.0 <= power_strip_mount_plate_size.z,
       "Power-strip screw pilots need at least 2 mm of closed ABS floor");
assert(power_strip_screw_pilot_entry_depth <
           power_strip_screw_pilot_depth,
       "Power-strip pilot entry chamfer must remain inside the pilot");
assert(abs(power_strip_screw_row_center_offset) +
           power_strip_small_hole_centres / 2 +
           power_strip_screw_pilot_entry_diameter / 2 <
           power_strip_mount_plate_size.x / 2,
       "Power-strip supplied-screw pilots need printable side walls");
assert(abs(power_strip_rail_center_offset) +
           power_strip_rail_countersink_diameter / 2 <
           power_strip_mount_plate_size.x / 2,
       "Power-strip rail countersinks need printable side walls");
assert(power_strip_rail_hole_pitch / 2 +
           power_strip_rail_countersink_diameter / 2 <
           power_strip_mount_plate_size.y / 2,
       "Power-strip rail countersinks need printable end walls");
assert(sqrt(pow(power_strip_rail_center_offset -
                    (power_strip_screw_row_center_offset -
                     power_strip_small_hole_centres / 2), 2) +
            pow(power_strip_rail_hole_pitch / 2, 2)) >
           power_strip_rail_countersink_diameter / 2 +
           power_strip_screw_pilot_entry_diameter / 2 + 2.0,
       "Power-strip rail and supplied-screw holes need a 2 mm ABS web");
assert(power_strip_inside_rail_face_x == frame_outer.x - profile_size &&
       power_strip_mount_face_x < power_strip_inside_rail_face_x &&
       power_strip_body_left_x >= profile_size,
       "Power strip must stay inboard of the lower right depth rail");
assert(power_strip_operator_y >= profile_size &&
       power_strip_device_y <= frame_outer.y - profile_size,
       "Power strip must fit between the operator/device corner posts");
assert(min(power_strip_block_y) - power_strip_mount_plate_size.y / 2 >=
           fixture_bar_y + 26.0,
       "Right-rail power-strip blocks must clear the fixture-bar connector");
assert(max(power_strip_block_y) + power_strip_mount_plate_size.y / 2 <=
           frame_outer.y - profile_size,
       "Right-rail power-strip blocks must clear the device-side corner post");
assert(power_strip_cable_operator_y >= profile_size &&
       power_strip_cable_left_x >= profile_size,
       "Power-strip cable keep-out must remain inside the lower frame");
assert(power_strip_bottom_z >= 0 &&
       power_strip_bottom_z + power_strip_body_size.z + 5.0 <=
           fixture_origin.z,
       "Lower-rail power strip needs 5 mm vertical clearance below fixture");
assert(2 * len(power_strip_pilot_coupon_diameters) >= 6,
       "Small ABS power-strip fit bed needs at least six cooling objects");
assert(ironing_coupon_count >= 6,
       "Small ABS ironing batches need at least six coupons for cooling");
assert((ironing_coupon_count - 1) * ironing_coupon_notch_pitch <
           ironing_coupon_size.y - 2 * ironing_coupon_corner_radius,
       "Ironing coupon edge marks must remain clear of rounded corners");
assert(registration_tab_size == [18.0, 92.0, 4.0],
       "Registration tabs must remain exactly 18 x 92 x 4 mm");
assert(registration_lower_engagement == 60.0 &&
       registration_above_frame == 32.0,
       "Registration tabs require 60 mm lower engagement and 32 mm upper engagement");
assert(registration_tab_size.x <= profile_size - 2.0,
       "Registration tabs must leave 1 mm of aluminum visible on each rail-face edge");
assert(registration_lower_hole_y == [12.0, 28.0],
       "Registration lower slots must preserve the 12 and 28 mm screw datums");
assert(registration_tab_size.y - registration_upper_lock_y -
           m5_clearance / 2 >= 4.0,
       "Registration upper lock needs at least 4 mm of material above the hole");
assert(CHASSIS_VARIANT != "dualbar_v1" ||
       (registration_upper_lock_corner_clearance == 7.0 &&
        registration_upper_lock_y ==
            registration_lower_engagement + profile_size / 2 +
                registration_upper_lock_corner_clearance),
       "Registration upper lock must preserve the owner-corrected 77 mm datum");
assert(registration_tab_count == 8 &&
       registration_tab_columns == 4 &&
       registration_tab_rows == 2,
       "Frame-hardware batch must contain exactly eight registration tabs");
assert(registration_tab_gap.x >= 4.0 &&
       registration_tab_gap.y >= 4.0,
       "Registration tabs need at least 4 mm of print-bed separation");
assert((registration_tab_size.x - registration_lower_slot.y) / 2 >= 4.0 &&
       (registration_tab_size.x - m5_clearance) / 2 >= 4.0,
       "Registration slots need at least 4 mm of material to each side");
registration_guide_bottom = frame_outer.z -
                            registration_lower_engagement;
assert(registration_guide_bottom + max(registration_lower_hole_y) <
       outer_rail_z.y - profile_size / 2,
       "Registration lower screws must land in the vertical extrusion");
assert(registration_guide_bottom + registration_upper_lock_y ==
           frame_outer.z + profile_size / 2 +
               registration_upper_lock_corner_clearance,
       "Registration upper lock must retain the 7 mm metal-corner clearance shift");
assert(cable_anchor_count == 8,
       "Wire-management starter batch must contain exactly eight anchors");
assert(CABLE_ANCHOR_FASTENER == "M5" ||
       CABLE_ANCHOR_FASTENER == "M3",
       str("Cable-anchor fastener must be M5 or M3, got: ",
           CABLE_ANCHOR_FASTENER));
assert(cable_anchor_size.y <= profile_size - 2.0,
       "Cable anchor must stay inside the 2020 rail face");
assert(cable_anchor_tie_passage.x + epsilon >=
           cable_anchor_tie_max_width + 0.8 &&
       cable_anchor_tie_passage.y + epsilon >=
           cable_anchor_tie_max_thickness + 0.8,
       "Cable-anchor passages need 0.8 mm clearance around the largest tie");
assert(cable_anchor_bridge_wall >= 1.6 &&
       cable_anchor_bridge_roof >= 1.6,
       "Cable-anchor tunnel walls and roof need two 0.8 mm nozzle lines");
assert(cable_anchor_entry_flare > 0 &&
       cable_anchor_entry_flare <= cable_anchor_bridge_roof / 4,
       "Cable-anchor entry flare must soften the tie edge without thinning the roof");
assert(min([for (x = cable_anchor_bridge_centres)
                abs(x) - cable_anchor_bridge_width / 2]) + epsilon >=
           cable_anchor_washer_diameter / 2 + 0.2,
       "Cable-anchor bridges must leave a flat washer seat");
assert(max([for (x = cable_anchor_bridge_centres)
                abs(x) + cable_anchor_bridge_width / 2]) <=
           cable_anchor_size.x / 2 - 1.6,
       "Cable-anchor bridges need printable end walls");
assert(cable_anchor_total_height >=
           cable_anchor_base_thickness + cable_anchor_head_stack,
       "Cable-anchor bridges must stand above the selected low-profile head");
assert(cable_anchor_batch_pitch.x >= cable_anchor_size.x + 4.0 &&
       cable_anchor_batch_pitch.y >= cable_anchor_size.y + 4.0,
       "Cable-anchor batch objects need at least 4 mm slicer separation");

module extrusion(length, axis, tint = [0.72, 0.74, 0.77]) {
    color(tint)
        pf_2020_extrusion(length, axis, profile_size,
                          EXTRUSION_DETAIL, extrusion_slot_opening,
                          extrusion_slot_depth, extrusion_centre_bore,
                          extrusion_slot_pocket_width,
                          extrusion_slot_lip_depth,
                          extrusion_slot_deep_width,
                          extrusion_web_thickness);
}

module outer_frame_bottom(tint = [0.72, 0.74, 0.77]) {
    for (y = [profile_size / 2, frame_outer.y - profile_size / 2])
        translate([profile_size, y, outer_rail_z.x])
            extrusion(structural_x_length, "x", tint);

    for (x = [profile_size / 2, frame_outer.x - profile_size / 2])
        translate([x, profile_size, outer_rail_z.x])
            extrusion(structural_y_length, "y", tint);
}

module outer_frame_posts(tint = [0.72, 0.74, 0.77]) {
    // The vertical posts are the stems of the delivered three-way joints.
    // Connector caps add 4 mm beyond each aluminum end.
    for (x = [profile_size / 2, frame_outer.x - profile_size / 2])
        for (y = [profile_size / 2, frame_outer.y - profile_size / 2])
            translate([x, y, frame_aluminum_z_min])
                extrusion(structural_z_length, "z", tint);
}

module outer_frame_top(tint = [0.72, 0.74, 0.77]) {
    for (y = [profile_size / 2, frame_outer.y - profile_size / 2])
        translate([profile_size, y, outer_rail_z.y])
            extrusion(structural_x_length, "x", tint);

    for (x = [profile_size / 2, frame_outer.x - profile_size / 2])
        translate([x, profile_size, outer_rail_z.y])
            extrusion(structural_y_length, "y", tint);
}

module outer_frame(tint = [0.72, 0.74, 0.77]) {
    // Width and depth rails butt into the post side faces. Their top/bottom
    // outer faces align with the connector-cap planes, with zero Z inset.
    outer_frame_bottom(tint);
    outer_frame_posts(tint);
    outer_frame_top(tint);
}

module fixture_gantry(tint = [0.72, 0.74, 0.77]) {
    // Uprights share the X planes of the outer depth rails.  This lets one
    // flat keyed plate bridge each T joint while the complete gantry slides
    // anywhere along the depth-rail slots.
    for (x = gantry_upright_x)
        for (segment = [0 : gantry_upright_segment_count - 1])
            translate([x, fixture_gantry_y,
                       gantry_clear_z_min +
                       segment * gantry_upright_segment_length])
                extrusion(gantry_upright_segment_length, "z", tint);

    // Concealed metal L-connectors let each crossbar slide vertically on the
    // uprights; plate fasteners then slide horizontally in these crossbars.
    for (z = fixture_crossbar_z)
        translate([profile_size, fixture_gantry_y, z])
            extrusion(gantry_crossbar_length, "x", tint);
}

module fixture_dualbars(tint = [0.72, 0.74, 0.77]) {
    // Two ordinary 306 mm rails span between the corresponding upper/lower
    // depth rails. Printed two-screw indexing plates slide as a matched pair,
    // retaining camera-distance adjustment without fixture uprights.
    for (z = fixture_bar_z)
        translate([profile_size, fixture_bar_y, z])
            extrusion(fixture_bar_length, "x", tint);
}

module fixture_support(tint = [0.72, 0.74, 0.77]) {
    if (CHASSIS_VARIANT == "dualbar_v1")
        fixture_dualbars(tint);
    else
        fixture_gantry(tint);
}

module usb_c_interrupter_at_installed_datum() {
    // Printable local +Z points toward the operator; local +Y becomes world
    // +Z so the paired receptacles hang below the upper fixture rail.
    multmatrix([
        [1, 0, 0, usbci_mount_center_x],
        [0, 0, -1, usbci_rail_contact_y],
        [0, 1, 0, usbci_face_center_z],
        [0, 0, 0, 1]
    ]) children();
}

module installed_usb_c_interrupter_bracket(show_module = false,
                                            tint = [0.95, 0.53, 0.12]) {
    color(tint)
        usb_c_interrupter_at_installed_datum()
            usb_c_interrupter_bracket(
                USB_C_INTERRUPTER_M17_PILOT_DIAMETER);
    if (show_module)
        usb_c_interrupter_at_installed_datum()
            usb_c_interrupter_proxy();
}

module usb_c_interrupter_installed_preview() {
    assert(CHASSIS_VARIANT == "dualbar_v1",
           "USB-C interrupter is installed only on the dual-bar fixture");
    translate([profile_size, fixture_bar_y, fixture_bar_z.y])
        extrusion(fixture_bar_length, "x", [0.72, 0.74, 0.77, 0.72]);
    dualbar_joint_plate_previews();
    fixture_plate_preview("proxy", [0.88, 0.88, 0.84, 0.45]);
    dualbar_fixture_mount_previews();
    installed_usb_c_interrupter_bracket(true);
}

module three_way_end_connector_proxy(x_right = false,
                                     y_rear = false,
                                     top = false) {
    // BLCCLOY B08C9Q2TGW proxy corrected from the physical joint: a square cap
    // sits on the vertical-post end and two thin tongues run inward along the
    // width/depth rail slots. Fine ribs and M4 set screws are omitted.
    cap_thickness = connector_end_overhang;
    tongue_length = 28.0;
    tongue_width = 8.0;
    tongue_thickness = 3.2;
    x0 = x_right ? frame_outer.x - profile_size : 0;
    y0 = y_rear ? frame_outer.y - profile_size : 0;
    cap_z = top ? frame_aluminum_z_max : 0;
    tongue_z = top ? frame_aluminum_z_max - tongue_thickness :
                     frame_aluminum_z_min;
    color([0.08, 0.08, 0.09]) {
        translate([x0, y0, cap_z])
            cube([profile_size, profile_size, cap_thickness]);

        translate([x_right ? x0 - tongue_length : x0 + profile_size,
                   y0 + (profile_size - tongue_width) / 2,
                   tongue_z])
            cube([tongue_length, tongue_width, tongue_thickness]);

        translate([x0 + (profile_size - tongue_width) / 2,
                   y_rear ? y0 - tongue_length : y0 + profile_size,
                   tongue_z])
            cube([tongue_width, tongue_length, tongue_thickness]);
    }
}

module gantry_l_connector_proxy_shape(down = false) {
    // BLCCLOY B08D6T9CGN: concealed zinc 26 x 26 x 9.5 mm L connector.
    connector_length = 26.0;
    connector_width = 9.5;
    connector_thickness = 3.0;

    color([0.10, 0.10, 0.11]) {
        translate([0, 0, -connector_width / 2])
            cube([connector_length, connector_thickness,
                  connector_width]);
        translate([-connector_width, 0,
                   down ? -connector_length + connector_width / 2 :
                          -connector_width / 2])
            cube([connector_width, connector_thickness,
                  connector_length]);
    }

    // Presentation-only screw heads make the adjustment face and its access
    // direction readable in the handbook. The production connector remains
    // represented by the catalog dimensions above.
    color([0.72, 0.74, 0.77])
        for (position = [
            [connector_length / 2, -0.2, 0],
            [-connector_width / 2, -0.2,
             (down ? -1 : 1) *
             (connector_length - connector_width) / 2]
        ])
            translate(position)
                rotate([90, 0, 0])
                    cylinder(h = 0.8, d = 4.0, $fn = 24);
}

module gantry_l_connector_proxy(y, z, right = false, down = false) {
    x_origin = right ? frame_outer.x - profile_size : profile_size;

    translate([x_origin,
               y - profile_size / 2 - 3.0,
               z])
        if (right)
            mirror([1, 0, 0])
                gantry_l_connector_proxy_shape(down);
        else
            gantry_l_connector_proxy_shape(down);
}

module connector_proxies() {
    outer_corner_connector_proxies();
    fixture_connector_proxies();
    if (CHASSIS_VARIANT == "legacy_gantry") {
        gantry_joint_plate_previews();
        gantry_splice_previews();
    } else {
        dualbar_joint_plate_previews();
    }
}

module outer_corner_connector_proxies(top_values = [false, true]) {
    for (x_right = [false, true])
        for (y_rear = [false, true])
            for (top = top_values)
                three_way_end_connector_proxy(x_right, y_rear, top);
}

module gantry_crossbar_connector_proxies() {
    for (z = fixture_crossbar_z)
        for (right = [false, true])
            gantry_l_connector_proxy(
                fixture_gantry_y, z, right,
                z == fixture_crossbar_z.y);
}

module fixture_connector_proxies() {
    if (CHASSIS_VARIANT == "legacy_gantry")
        gantry_crossbar_connector_proxies();
}

module installed_dualbar_joint_plate(z, right = false) {
    upper = z == fixture_bar_z.y;
    keyed_depth = gantry_joint_plate_size.z + gantry_joint_key_height;
    joint_x = right ? frame_outer.x - profile_size : profile_size;
    plate_center_x = right ? joint_x - profile_size / 2 :
                             joint_x + profile_size / 2;
    rail_inner_face_z = upper ? z - profile_size / 2 :
                                z + profile_size / 2;

    // Local X -> world Y. Local Y reaches the depth-rail center at -10 mm
    // and the fixture-bar center at +10 mm; the right joint mirrors that
    // relationship. Local +Z points into the aluminum, so the broad plate
    // always stays in the clear volume between the upper and lower rails.
    multmatrix([
        [0, right ? -1 : 1, 0, plate_center_x],
        [1, 0, 0, fixture_bar_y],
        [0, 0, upper ? 1 : -1,
         rail_inner_face_z + (upper ? -keyed_depth : keyed_depth)],
        [0, 0, 0, 1]
    ]) gantry_joint_plate();
}

module dualbar_joint_plate_previews() {
    color([0.94, 0.47, 0.10])
        for (z = fixture_bar_z)
            for (right = [false, true])
                installed_dualbar_joint_plate(z, right);
}

module installed_gantry_joint_plate(y, top = false, right = false) {
    joint_z = top ? gantry_clear_z_max : gantry_clear_z_min;
    keyed_depth = gantry_joint_plate_size.z + gantry_joint_key_height;
    face_x = right ? frame_outer.x - profile_size : profile_size;

    // Local X -> world Y, local Y -> world Z.  The top instance reverses
    // local Y so the horizontal key always enters the outer depth rail and
    // the vertical key always enters the gantry upright.  Local +Z points
    // toward the aluminum, leaving the broad plate in the clear interior.
    multmatrix([
        [0, 0, right ? 1 : -1,
         right ? face_x - keyed_depth : face_x + keyed_depth],
        [1, 0, 0, y],
        [0, top ? -1 : 1, 0, joint_z],
        [0, 0, 0, 1]
    ]) gantry_joint_plate();
}

module gantry_joint_plate_previews() {
    color([0.94, 0.47, 0.10])
        for (top = [false, true])
            for (right = [false, true])
                installed_gantry_joint_plate(fixture_gantry_y, top, right);
}

module fixture_mesh_at_installed_datum(mesh_path) {
    translate(fixture_origin)
        rotate([90, 0, 0])
            import(mesh_path, convexity = 10);
}
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
