pocketforge-os/test-node-hw/mechanical/dut-chassis-2020-v1/power-system-fit-coupon.scad

/*
 * Disposable, support-free ALT-1205T / IEC C14 / M3 process fit coupon.
 *
 * FIT COUPON ONLY -- NEVER A MAINS ENCLOSURE OR POWERED-WIRE GUARD.
 * PSU coordinates retain the component library's underside top-left datum.
 */

include <lib/alt-1205t-power-supply.scad>
include <lib/iec-c14-fused-switch.scad>

IEC_CLEARANCE = is_undef(IEC_CLEARANCE) ? 0.20 : IEC_CLEARANCE; // per side
M3_HOLE_CLEARANCE = is_undef(M3_HOLE_CLEARANCE) ? 0.40 : M3_HOLE_CLEARANCE; // on diameter
NUT_TRAP_CLEARANCE = is_undef(NUT_TRAP_CLEARANCE) ? 0.25 : NUT_TRAP_CLEARANCE; // across flats
WALL_THICKNESS = is_undef(WALL_THICKNESS) ? 3.0 : WALL_THICKNESS;
PART = is_undef(PART) ? "printable_coupon" : PART;

function coupon_m3_nominal_diameter() = 3.0;
function coupon_m3_hole_diameter() = coupon_m3_nominal_diameter() + M3_HOLE_CLEARANCE;
function coupon_nut_nominal_af() = 5.5;
function coupon_nut_nominal_thickness() = 2.4;
function coupon_nut_pocket_af() = coupon_nut_nominal_af() + NUT_TRAP_CLEARANCE;
function coupon_nut_pocket_depth() = coupon_nut_nominal_thickness() + 0.20;
function coupon_iec_nominal_profile() = iecc14_body_profile_size();
function coupon_iec_clearanced_profile() = [
    coupon_iec_nominal_profile().x + 2 * IEC_CLEARANCE,
    coupon_iec_nominal_profile().y + 2 * IEC_CLEARANCE
];
function coupon_iec_snap_wall_target() = 1.2;
function coupon_iec_surface_allowance() = 0.1;
function coupon_iec_budgeted_wall_max() = 1.3;
function coupon_iec_owner_wall_hard_limit() = 1.5;
function coupon_iec_faceplate_overlap_per_side() = [
    (iecc14_faceplate_size().x - coupon_iec_clearanced_profile().x) / 2,
    (iecc14_faceplate_size().y - coupon_iec_clearanced_profile().y) / 2
];
function coupon_slot_origin() = [
    alt1205t_base_size().x - alt1205t_upper_right_slot_right_tangent()
        - alt1205t_upper_right_slot_size().x,
    alt1205t_upper_right_slot_top_tangent()
];
function coupon_bottom_slot_origin() = alt1205t_bottom_slot_origin();
function coupon_bottom_slot_size() = alt1205t_bottom_slot_size();
function coupon_iec_centre() = [-19, 80];
function coupon_panel_size() = [35, 54];
function coupon_nut_centre() = [85, 8];
function coupon_rib_width() = 7;
function coupon_pad_diameter() = 11;
function coupon_psu_outline_margin() = 2;
function coupon_register_height() = 2.0;
function coupon_register_thickness() = 2.0;
function coupon_register_length() = 24;

module coupon_contract() {
    assert(alt1205t_base_size() == [77.5, 110], "PSU absolute datum outline changed");
    assert(alt1205t_m3_centres() ==
               [[25.3,30.9], [25.3,67], [53.3,67]],
           "PSU second-fit internal coupon centres changed");
    assert(alt1205t_upper_left_m3_centre() == [4.95,4.95] &&
           alt1205t_lower_left_m3_centre() == [6.75,98.6] &&
           alt1205t_all_m3_centres() ==
               [[4.95,4.95], [25.3,30.9], [25.3,67], [53.3,67], [6.75,98.6]],
           "PSU release edge M3 checks or combined five-hole contract changed");
    assert(coupon_slot_origin() == [71.05, 2.94] &&
           coupon_slot_origin().x + alt1205t_upper_right_slot_size().x ==
               alt1205t_base_size().x - 3.15,
           "PSU slot tangent contract changed");
    assert(coupon_bottom_slot_origin() == [2.28,106] &&
           coupon_bottom_slot_size() == [2.61,4] &&
           coupon_bottom_slot_origin().y + coupon_bottom_slot_size().y ==
               alt1205t_base_size().y,
           "PSU bottom-open slot datum contract changed");
    assert(coupon_iec_nominal_profile() == [27,46.86] &&
           coupon_iec_clearanced_profile() ==
               [27 + 2*IEC_CLEARANCE, 46.86 + 2*IEC_CLEARANCE],
           "IEC nominal and clearanced profiles must remain distinct");
    assert(coupon_iec_faceplate_overlap_per_side().x > 0 &&
           coupon_iec_faceplate_overlap_per_side().y > 0,
           "IEC faceplate must cover the clearanced panel opening on every side");
    assert(coupon_iec_centre() == [-19,80] && coupon_panel_size() == [35,54],
           "IEC coupon XY placement or panel outline changed");
    assert(coupon_iec_snap_wall_target() == 1.2 &&
           coupon_iec_surface_allowance() == 0.1 &&
           coupon_iec_budgeted_wall_max() == 1.3 &&
           coupon_iec_owner_wall_hard_limit() == 1.5 &&
           coupon_iec_snap_wall_target() + coupon_iec_surface_allowance() ==
               coupon_iec_budgeted_wall_max() &&
           coupon_iec_budgeted_wall_max() < coupon_iec_owner_wall_hard_limit(),
           "IEC 1.2 + 0.1 mm budget must remain below the 1.5 mm owner limit");
    assert(coupon_iec_snap_wall_target() < WALL_THICKNESS,
           "IEC snap panel must remain distinct from the structural coupon wall");
    assert(WALL_THICKNESS > 0, "Coupon wall thickness must be positive");
    assert(IEC_CLEARANCE >= 0 && M3_HOLE_CLEARANCE >= 0 && NUT_TRAP_CLEARANCE >= 0,
           "Print clearances cannot be negative");
    assert(coupon_m3_hole_diameter() == 3 + M3_HOLE_CLEARANCE,
           "M3 clearance must apply to the nominal diameter");
    assert(coupon_nut_nominal_af() == 5.5 && coupon_nut_nominal_thickness() == 2.4 &&
           coupon_nut_pocket_af() == 5.5 + NUT_TRAP_CLEARANCE &&
           coupon_nut_pocket_depth() == 2.6,
           "M3 nut-trap nominal or clearance mapping changed");
    assert(coupon_nut_centre() == [85,8],
           "Separate M3 nut-sampler placement changed");
    assert(coupon_register_height() == 2.0 &&
           coupon_register_thickness() == 2.0 &&
           coupon_register_length() == 24,
           "PSU datum-register geometry changed");
    assert(coupon_nut_pocket_depth() < WALL_THICKNESS,
           "Nut pocket must retain a printable floor");
    assert(coupon_pad_diameter()/2 - coupon_m3_hole_diameter()/2 >= 3,
           "Every closed M3 check needs at least 3 mm radial material in its pad");
    children();
}

module rib_between(a, b, width = coupon_rib_width()) {
    hull() for (p = [a,b]) translate(p) circle(d=width, $fn=24);
}

module psu_sparse_outline_2d() {
    centres = alt1205t_all_m3_centres();
    internal_centres = alt1205t_m3_centres();
    slot_centre = coupon_slot_origin() + alt1205t_upper_right_slot_size()/2;
    bottom_slot_centre = coupon_bottom_slot_origin() +
                         coupon_bottom_slot_size()/2;
    outline_margin = coupon_psu_outline_margin();
    union() {
        // Exact top/left outline references make the absolute datum physical.
        translate([-outline_margin, -outline_margin])
            square([alt1205t_base_size().x + 2*outline_margin, 6]);
        translate([-outline_margin, -outline_margin])
            square([6, alt1205t_base_size().y + 2*outline_margin]);
        // Positive pads close the upper-left and lower-left M3 checks even
        // though both lie close to the measured exterior edges.
        translate([-5, -5]) square([8, 8]);
        for (p = centres) translate(p) circle(d=coupon_pad_diameter(), $fn=36);
        rib_between(alt1205t_upper_left_m3_centre(), internal_centres[0]);
        rib_between(internal_centres[0], internal_centres[1]);
        rib_between(internal_centres[1], internal_centres[2]);
        rib_between([2,2], slot_centre);
        translate(slot_centre) circle(d=9, $fn=30);
        // Local material surrounds the bottom-open slot while allowing its
        // negative to continue through the coupon's +Y outside margin.
        translate([0, coupon_bottom_slot_origin().y - 2])
            square([10, coupon_bottom_slot_size().y + 2 + outline_margin]);
        rib_between(alt1205t_lower_left_m3_centre(), bottom_slot_centre);
    }
}

module iec_panel_2d() {
    translate(coupon_iec_centre()) square(coupon_panel_size(), center=true);
}

module nut_sampler_2d() {
    translate(coupon_nut_centre()) circle(d=13, $fn=36);
    rib_between([alt1205t_base_size().x - 2, 2], coupon_nut_centre(), 6);
}

module coupon_blank() {
    union() {
        linear_extrude(height=WALL_THICKNESS)
            union() { psu_sparse_outline_2d(); nut_sampler_2d(); }
        // Only the snap-in inlet test panel is thin. The PSU ribs and nut
        // sampler retain the structural 3.0 mm coupon thickness.
        linear_extrude(height=coupon_iec_snap_wall_target()) iec_panel_2d();
        // The PSU sits on the Z=WALL_THICKNESS face and is pushed up/left.
        // These outside-only legs expose crisp inside faces at the exact X=0
        // and Y=0 datum axes without occupying any of the PSU plan envelope.
        translate([-coupon_register_thickness(), 0, WALL_THICKNESS])
            cube([coupon_register_thickness(), coupon_register_length(),
                  coupon_register_height()]);
        translate([0, -coupon_register_thickness(), WALL_THICKNESS])
            cube([coupon_register_length(), coupon_register_thickness(),
                  coupon_register_height()]);
        translate([-coupon_register_thickness(), -coupon_register_thickness(),
                   WALL_THICKNESS])
            cube([coupon_register_thickness(), coupon_register_thickness(),
                  coupon_register_height()]);
    }
}

module hex_prism(af, height) {
    cylinder(r=af/sqrt(3), h=height, $fn=6);
}

module coupon_upper_left_register_clearance_negative() {
    // Extend the same M3 negative through the full register-height envelope.
    // The final-fit centre no longer intersects the outside-only shoulder, but
    // keeping one complete negative path protects a usable through-hole.
    p = alt1205t_upper_left_m3_centre();
    translate([p.x, p.y, -0.01])
        cylinder(d=coupon_m3_hole_diameter(),
                 h=WALL_THICKNESS + coupon_register_height() + 0.02, $fn=36);
}

module printable_coupon() {
    coupon_contract()
    difference() {
        coupon_blank();
        // Use the reviewed PSU library negative; sparse material selects only
        // connected holes/slot needed by this coupon.
        alt1205t_mounting_negatives(
            WALL_THICKNESS, coupon_m3_hole_diameter(),
            coupon_psu_outline_margin() + 0.02);
        coupon_upper_left_register_clearance_negative();
        // Use only the rigid insertion negative: relaxed tongues are deliberately
        // excluded so the real tongues must compress, pass, spring out and retain.
        translate([coupon_iec_centre().x, coupon_iec_centre().y, 0])
            iecc14_panel_cutout_negative(coupon_iec_snap_wall_target(), IEC_CLEARANCE);
        translate([coupon_nut_centre().x, coupon_nut_centre().y, -0.01])
            cylinder(d=coupon_m3_hole_diameter(), h=WALL_THICKNESS + 0.02, $fn=36);
        translate([coupon_nut_centre().x, coupon_nut_centre().y,
                   WALL_THICKNESS - coupon_nut_pocket_depth()])
            hex_prism(coupon_nut_pocket_af(), coupon_nut_pocket_depth() + 0.01);
    }
}

module evidence_overlay() {
    color([0.05,0.42,0.82,0.45])
        translate([0,0,WALL_THICKNESS+0.02])
            linear_extrude(height=0.12) difference() {
                square(alt1205t_base_size());
                offset(delta=-0.35) square(alt1205t_base_size());
            }
    for (p=alt1205t_all_m3_centres())
        color([1,0.45,0.05]) translate([p.x,p.y,WALL_THICKNESS+0.04]) cylinder(d=1,h=0.16,$fn=20);
    for (i=[0:len(alt1205t_m3_centres())-1]) {
        p=alt1205t_m3_centres()[i];
        color([0.1,0.1,0.1]) translate([p.x+3,p.y-3,WALL_THICKNESS+0.04])
            linear_extrude(height=0.16) text(str("(",p.x,",",p.y,")"),size=2.2);
    }
    color([0.1,0.1,0.1]) translate([8,5,WALL_THICKNESS+0.04])
        linear_extrude(height=0.16) text("UL M3 (4.95,4.95)",size=1.7);
    color([0.1,0.1,0.1]) translate([12,99,WALL_THICKNESS+0.04])
        linear_extrude(height=0.16) text("LL M3 (6.75,98.6)",size=1.7);
    color([0.1,0.1,0.1]) translate([coupon_slot_origin().x-25,8,WALL_THICKNESS+0.04])
        linear_extrude(height=0.16) text("SLOT 3.3x4.7  T2.94  R3.15",size=1.45);
    color([0.1,0.1,0.1])
        translate([8, coupon_bottom_slot_origin().y+3,
                   WALL_THICKNESS+0.04])
            rotate([0,0,-90]) linear_extrude(height=0.16)
                text("OPEN SLOT  X2.28  W2.61  H4.0",size=1.6);
    color([0.1,0.75,0.35,0.55]) translate([coupon_iec_centre().x,coupon_iec_centre().y,coupon_iec_snap_wall_target()+0.03])
        linear_extrude(height=0.14) difference() {
            iecc14_panel_profile_2d(IEC_CLEARANCE);
            iecc14_panel_profile_2d(0);
        }
    color([0.85,0.05,0.05]) translate([-35,109,WALL_THICKNESS+0.04])
        linear_extrude(height=0.16) text("FIT COUPON", size=3.7,
                                         font="Liberation Sans:style=Bold");
    color([0.85,0.05,0.05]) translate([-35,105,WALL_THICKNESS+0.04])
        linear_extrude(height=0.16) text("NO MAINS", size=3.3,
                                         font="Liberation Sans:style=Bold");
    color([0.55,0.05,0.75]) translate([3,9,WALL_THICKNESS+coupon_register_height()+0.04])
        linear_extrude(height=0.16) text("SLIDE -X / -Y TO REGISTER", size=2.2,
                                         font="Liberation Sans:style=Bold");
    color([0.95,0.4,0.05]) translate([-35,100.5,WALL_THICKNESS+0.04])
        linear_extrude(height=0.16) text("ORANGE: 5 M3 CENTRES", size=1.75);
    color([0.05,0.6,0.25]) translate([-35,97.5,WALL_THICKNESS+0.04])
        linear_extrude(height=0.16) text("GREEN: IEC +0.20 / SIDE", size=1.65);
    color([0.1,0.1,0.1]) translate([-35,53,WALL_THICKNESS+0.04])
        linear_extrude(height=0.16) text("IEC NOM 27x46.86",size=2.4);
    color([0.1,0.1,0.1]) translate([-35,94.5,WALL_THICKNESS+0.04])
        linear_extrude(height=0.16) text("IEC WALL 1.2 + 0.1 = 1.3 < 1.5",size=1.2);
    color([0.1,0.1,0.1]) translate([-35,92,WALL_THICKNESS+0.04])
        linear_extrude(height=0.16) text("STRUCTURE 3.0",size=1.6);
    color([0.55,0.05,0.75]) translate([72,18,WALL_THICKNESS+0.04])
        linear_extrude(height=0.16) text("NUT SAMPLE",size=1.7,
                                         font="Liberation Sans:style=Bold");
    color([0.55,0.05,0.75]) translate([77,15.7,WALL_THICKNESS+0.04])
        linear_extrude(height=0.16) text("NOT PSU",size=1.6,
                                         font="Liberation Sans:style=Bold");
}

if (PART == "printable_coupon") printable_coupon();
else if (PART == "evidence") {
    printable_coupon();
    evidence_overlay();
} else assert(false, str("Unknown power-system fit-coupon PART: ", PART));
