pocketforge-os/test-node-hw/mechanical/dut-fixture-v1/bpi-m2-zero-v1.scad

/*
 * Banana Pi BPI-M2 Zero V1.0 presentation model.
 *
 * This is an original, source-native reconstruction of the populated board in
 * the PocketForge fixture. No third-party mesh or DXF geometry is embedded.
 * Interface dimensions come from owner caliper measurements; connector and
 * component registration was cross-checked against Sinovoip's public V1.0
 * top/bottom DXF and the owner's 2026-07-18 fixture photograph. See
 * BPI-M2-ZERO-PROVENANCE.md for immutable reference hashes and URLs.
 *
 * Local coordinates: X across the 29.90 mm short axis, Y along the 65.00 mm
 * long axis from CSI end to antenna end, Z upward from the PCB underside.
 * Values are millimetres.
 */

function bpi_m2_zero_board_size() = [29.90, 65.00];
function bpi_m2_zero_hole_diameter() = 2.60;
function bpi_m2_zero_hole_centres() = [23.00, 58.36];
function bpi_m2_zero_board_thickness() = 1.60;
function bpi_m2_zero_top_dxf_sha256() =
    "7adbb58ab77addc91a5fc2ee84df689e5db62e7ed2b9b2b12b166684b1632833";
function bpi_m2_zero_bottom_dxf_sha256() =
    "9d0815fd9bdb3cb5dd790d8dda1eb132a36802b586dc5eab696c79cea3dc592a";

bpi_board = bpi_m2_zero_board_size();
bpi_hole_pitch = bpi_m2_zero_hole_centres();
bpi_hole_d = bpi_m2_zero_hole_diameter();
bpi_pcb_t = bpi_m2_zero_board_thickness();
bpi_corner_radius = 3.0;
bpi_epsilon = 0.02;

module bpi_rounded_rect_2d(size, radius) {
    hull()
        for (x = [radius, size.x - radius])
            for (y = [radius, size.y - radius])
                translate([x, y]) circle(r = radius, $fn = 32);
}

module bpi_rounded_prism(origin, size, radius = 0.35) {
    translate(origin)
        linear_extrude(height = size.z)
            bpi_rounded_rect_2d([size.x, size.y],
                               min(radius, min(size.x, size.y) / 2));
}
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
