pocketforge-os/test-node-hw/(commit log)

2026-07-01 Initial repo: design docs + grounding-ref + placement template + part libs
    PocketForge test-node board (Track D, tsp-bcx.12) EDA sources for the PCB designer:
    - docs/00-IAN-START-HERE + 01-design-brief + 02-netlist-wiring-guide + 03-BOM
    (buck DECIDED = LTC3649) + 04-grounding-and-sense-reference (layout-critical) +
    05-abs-max-and-safety-spice
    - kicad/test-node-placement-template.kicad_sch (placement head-start; signal wiring TBD)
    - lib/ (easyeda2kicad-pulled symbols+footprints: TS3A27518E, GL823K, AO3400A; process
    documented for the rest)
    PCB order gated on the Fri EE review + tsp-bcx.9 bench current.
    [test-node-placement-template.kicad_sch]
2026-07-01 BOM: protection + power-tree parts decided (SCR/fuse/TVS/rev-pol/inductor/3V3 buck) + footprints
    - docs/03-BOM.md: X0202MN crowbar SCR (C221522), 0466003 fuse (C14165, I2t coordinated),
    SMAJ5.0A cell TVS (C140902), SMBJ15A 12V TVS (C135046), AO3401A rev-pol P-FET (C15127),
    Sunlord 1uH post-filter inductor (C98348), MP2315 3.3V buck (C45889), AO3400A sink FET.
    3 flags for Friday: cell-TVS clamp compromise (crowbar is primary), rev-pol thermal @3A,
    post-filter=inductor-not-bead.
    - lib/: easyeda2kicad footprints+symbols+3D for all of the above pulled from LCSC.
2026-07-03 tsp-mx3: retarget caller at pocketforge-os/shared-workflows
    Public repos cannot call the workflow_call reusable workflow in
    pocketforge-os/pocketforge-automation (which is private) — GitHub blocks
    public→private workflow_call inside the same org. Split the reusable gate
    into a new PUBLIC repo pocketforge-os/shared-workflows and retarget every
    tsp-mx3 rollout caller at:
    uses: pocketforge-os/shared-workflows/.github/workflows/pr-review-gate.yml@main
    Job id `pf-pr-review` unchanged; check context is still "pf-pr-review /
    review" (uniform org-wide). No functional change for private repos; the
    public repos will now succeed at parse time and produce a real review check.
    Also refreshed the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
2026-07-04 pr-review: add PR checklist template (infra-251 A1)
    Adds .github/pull_request_template.md — the canonical PocketForge PR checklist
    template (## Summary / ## Test plan GFM task list / ## Related PRs) so every new
    PR in this repo pre-fills the three required sections. Identical copy of the
    canonical template landed in mission-control (see Related PRs).
    Part of tsp-a5y.15 (infra-251 Phase A1 — org-wide template rollout).
    Claude-Session: https://claude.ai/code/session_0112B3jWZjydokMQ6ubtufHR
2026-07-12 tsp-bcx.24: scrub abandoned power-button presser from board design + docs
    Remove the SUBSYSTEM E power-button-presser design (PhotoMOS across the device
    button pads, BTN_A/BTN_B nets, BTN_DRV, servo 5V rail) and repoint power-on to
    the harness battery/VBUS relay doctrine. Power-button actuation is permanently
    abandoned (owner-directed 2026-07-12, tsp-bcx.24; presser bead tsp-bcx.10 closed
    won't-do): pads are un-solderable and no mechanical presser will be pursued.
    - docs/01-design-brief.md: SUBSYSTEM E rewritten to "POWER-ON = HARNESS RELAYS";
    drop BTN_DRV/photoMOS from the ESP32 GPIO budget; signal-connector pins 4-5
    (ex BTN_A/BTN_B) → RSVD; 5V servo rail → general-purpose aux (DNP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
2026-07-16 tsp-ikk0.8: caller-level per-PR concurrency — cancel superseded review runs at trigger time
    Org-wide rollout of the canonical caller change (pocketforge-os/pocketforge-automation#168).
    Group name deliberately distinct from the gate job's group — identical
    workflow+job level groups deadlock the run (vscode-github-actions#135).
    Claude-Session: https://claude.ai/code/session_012ik3pafy2HhD8m9nwFde2X
2026-07-17 tsp-ikk0.21: adopt edited-trigger PR-review caller
    Copies the pa#182 / shared-workflows#4 canonical thin-caller mechanics —
    edited event type, title-only-skip if-guard, -noop concurrency diversion —
    preserving this repo's uses: target byte-for-byte.
    Related PRs: pocketforge-os/pocketforge-automation#182,
    pocketforge-os/shared-workflows#4.
2026-07-19 Add parametric DUT harness fixture plate
    [dut-fixture.scad]
2026-07-19 Fix DUT fixture layout and enforce clearances
    [dut-fixture.scad]
2026-07-19 Correct ESP32 fixture dimensions
    [dut-fixture.scad]
2026-07-19 Adapt DUT fixture for 4040 frame
    [dut-fixture.scad]
2026-07-19 Exclude preview ghosts from STL exports
    [dut-fixture.scad]
2026-07-19 Correct fixture connector clearances
    [dut-fixture.scad]
2026-07-19 fix fixture ESP32 ties and split joiner holes
    [dut-fixture.scad]
2026-07-19 tsp-bcx.21.21: refine fixture from physical fit
    [dut-fixture.scad]
2026-07-19 tsp-bcx.21.22: add parametric DUT cradle
    [trimui-smart-pro-s-cradle.scad]
2026-07-19 tsp-bcx.21.22: strengthen carrier labels for 0.8mm nozzle
    [trimui-smart-pro-s-cradle.scad]
2026-07-19 tsp-bcx.21.22: enlarge carrier lettering
    [trimui-smart-pro-s-cradle.scad]
2026-07-19 tsp-bcx.21.22: scale carrier labels for coarse nozzle
    [trimui-smart-pro-s-cradle.scad]
2026-07-20 tsp-bcx.21.22: add shared Smart Pro cradle family
    [trimui-smart-pro-cradle.scad, trimui-smart-pro-family-cradle.scad, trimui-smart-pro-s-cradle.scad]
2026-07-20 tsp-bcx.21.22: fully capture cradle hook nuts
    [trimui-smart-pro-family-cradle.scad]
2026-07-20 tsp-bcx.21.22: refine hook fit and trigger clearance
    [trimui-smart-pro-family-cradle.scad]
2026-07-20 tsp-bcx.21.22: tighten cradle hook nut fit
    [trimui-smart-pro-family-cradle.scad]
2026-07-20 tsp-bcx.21.22: snug cradle hook nut pocket
    [trimui-smart-pro-family-cradle.scad]
2026-07-21 Add parametric TrimUI Brick DUT cradle
    [trimui-brick-cradle.scad]
2026-07-21 Enlarge Brick cradle labels and reserve margin
    [trimui-brick-cradle.scad]
2026-07-21 Standardize Brick device title at top
    [trimui-brick-cradle.scad]
2026-07-21 Widen Brick title box for readable label
    [trimui-brick-cradle.scad]
2026-07-21 tsp-bcx.21.23: give Brick hooks a flat print spine
    [trimui-brick-cradle.scad]
2026-07-21 tsp-bcx.21.23: enforce hook bed contact area
2026-07-21 feat(mechanical): model stackable 2020 DUT chassis
    [pocketforge-node-chassis.scad]
2026-07-22 feat(mechanical): add adjustable DUT plate gantries
    [pocketforge-node-chassis.scad]
2026-07-22 feat(mechanical): package chassis fabrication outputs
    [pocketforge-node-chassis.scad]
2026-07-22 fix(mechanical): replace fine twist nut carriers
    [pocketforge-node-chassis.scad]
2026-07-22 cad: fit slider to full extrusion channel
    [pocketforge-node-chassis.scad]
2026-07-22 cad: replace nut nubbins with full-channel bars
    [pocketforge-node-chassis.scad]
2026-07-22 cad: build gantries from extrusion offcuts
    [pocketforge-node-chassis.scad]
2026-07-22 cad: show complete DUT cradle in chassis
    [pocketforge-node-chassis.scad, trimui-smart-pro-family-cradle.scad]
2026-07-22 cad: shorten M3 nut-bar fit coupon
    [pocketforge-node-chassis.scad]
2026-07-22 cad: match M3 nut bar to rail taper
    [pocketforge-node-chassis.scad]
2026-07-22 cad: select production M3 nut-bar profile
    [pocketforge-node-chassis.scad]
2026-07-22 feat(chassis): compact frame and reinforce gantry splices
    [pocketforge-node-chassis.scad]
2026-07-22 tsp-bcx.21.29.1: render cradle labels black
    [pocketforge-node-chassis.scad, trimui-smart-pro-family-cradle.scad]
2026-07-22 feat(chassis): fix carrier and reduce stock plan
    [pocketforge-node-chassis.scad]
2026-07-22 fix(chassis): align rails flush with corner caps
    [pocketforge-node-chassis.scad]
2026-07-22 feat(chassis): restore populated S presentation
    [dut-fixture.scad, pocketforge-node-chassis.scad]
2026-07-22 feat(chassis): add safe after-splice print batch
    [pocketforge-node-chassis.scad]
2026-07-22 feat(chassis): add self-indexing full splice collar
    [pocketforge-node-chassis.scad]
2026-07-22 cad: add independent chassis completion print batch
    [pocketforge-node-chassis.scad]
2026-07-23 chore: drop retired custom test-node PCB, keep DUT mechanical fixtures
    The custom test-node PCB effort (tsp-bcx.12 / infra-201 battery-emulator
    board — LTC3649 virtual battery, ESP32-S3, integrated SD mux) is retired in
    favor of the DUT-based test-node approach. Remove the KiCad project, part
    libraries/3D models, and the electronics design docs; they remain in git
    history if ever needed. Rewrite the README to describe the remaining
    mechanical CAD (chassis / cradle / fixture) so the now-public repo reflects
    its actual scope.
    [test-node-placement-template.kicad_sch]
2026-07-23 feat(chassis): finalize printable test-node frame
    [pocketforge-node-chassis.scad, trimui-smart-pro-family-cradle.scad]
2026-07-23 fix(chassis): show placard label color change
    [pocketforge-node-chassis.scad]
2026-07-23 feat(chassis): split placard print batches
    [pocketforge-node-chassis.scad]
2026-07-23 Add captive-nut and rail preload guide scenes
    [pocketforge-node-chassis.scad]
2026-07-23 docs(chassis): clarify V-slot rail render
    [pocketforge-node-chassis.scad]
2026-07-23 docs(chassis): render installed nameplate white and black
2026-07-23 ci: refresh handbook CAD after source merges
2026-07-23 docs(chassis): show splice collars in preload panel
    [pocketforge-node-chassis.scad]
2026-07-23 docs: explain parked replacement nut bars
    [pocketforge-node-chassis.scad]
2026-07-23 Keep loaded nuts visible in camera frame
    [pocketforge-node-chassis.scad]
2026-07-24 fix(chassis): restore compact M3 nut carriers
    [pocketforge-node-chassis.scad]
2026-07-25 Add rail-mounted cable tie anchors
    [pocketforge-node-chassis.scad]
2026-07-25 fix(chassis): halve power-strip block thickness
    [pocketforge-node-chassis.scad]
2026-07-25 Tighten cable anchor guide framing
2026-07-25 feat(fixture): model installed Banana Pi M2 Zero
    [bpi-m2-zero-v1.scad, dut-fixture.scad, pocketforge-node-chassis.scad]
2026-07-25 Make stacking tabs slimmer and longer
    [pocketforge-node-chassis.scad]
2026-07-26 feat(fixture): model ESP32-S3 SuperMini HW-747
    [dut-fixture.scad, esp32-s3-supermini-hw747-v0.0.2.scad, pocketforge-node-chassis.scad]
2026-07-26 feat: model exact Logitech C270 webcam
    [dut-fixture.scad, logitech-c270.scad, pocketforge-node-chassis.scad]
2026-07-26 cad: model exact ELEGOO relay board
    [dut-fixture.scad, elegoo-4-channel-relay.scad, pocketforge-node-chassis.scad]
2026-07-26 cad: reduce relay label tessellation
    [elegoo-4-channel-relay.scad]
2026-07-26 Model exact HiLetgo XL6009 boost board
    [dut-fixture.scad, hiletgo-xl6009.scad, pocketforge-node-chassis.scad]
2026-07-26 Add exact ALIENTEK DP100 fixture model
    [alientek-dp100.scad, dut-fixture.scad, pocketforge-node-chassis.scad]
2026-07-26 Model exact Ceksezx MTSD001 MOSFET module
    [ceksezx-mtsd001.scad, dut-fixture.scad, pocketforge-node-chassis.scad]
2026-07-26 Model final fixture antenna and USB hubs
    [dut-fixture.scad, eightwood-ewua0205.scad, pocketforge-node-chassis.scad, smays-microb-hub-8152.scad, vienon-usb-001.scad]
2026-07-26 fix: match installed USB hub stagger
    [dut-fixture.scad]
2026-07-26 Add deterministic device print packs
    [pocketforge-node-chassis.scad]
2026-07-26 feat: publish immutable qualified print packs
2026-07-27 fix: reconcile sole immutable print-pack release
2026-07-27 Gate handbook CAD refresh on artifact success
2026-07-27 Add gated Pro S top-bar chassis candidate
    [pocketforge-node-chassis.scad]
2026-07-27 Make top-bar Smart Pro S the canonical guide scene
    [pocketforge-node-chassis.scad]
2026-07-27 Export source-only browser device packs
2026-07-28 Rework Pro S fixture mount around dual support bars
    [pocketforge-node-chassis.scad]
2026-07-29 tsp-bcx.21.23: lighten Brick carrier placard
    [trimui-brick-cradle.scad]
2026-07-29 tsp-bcx.21.32: lighten DUT carrier labels
    [trimui-smart-pro-family-cradle.scad]
2026-07-29 tsp-bcx.21.23: lighten Brick orientation labels
    [trimui-brick-cradle.scad]
2026-07-29 tsp-bcx.21.32: retry stalled CI
    [trimui-smart-pro-family-cradle.scad]
2026-08-01 Move chassis power strip to bottom-right rail
    [pocketforge-node-chassis.scad]
2026-08-01 Add dual-bar assembly render sequence
    [pocketforge-node-chassis.scad]
2026-08-01 feat: add parametric extrusion square
    [right-angle-checker.scad]
2026-08-01 Move stacking tab upper hole 7 mm
    [pocketforge-node-chassis.scad]
2026-08-01 Preserve qualified legacy frame hardware
    [pocketforge-node-chassis.scad]
2026-08-01 Lock revised dual-bar frame hardware
2026-08-01 tsp-px73.23: keep chassis carrier links stack-clear
    [pocketforge-node-chassis.scad]
2026-08-01 tsp-px73.23: clarify printed joint preload
    [pocketforge-node-chassis.scad]
2026-08-03 tsp-t1zd.2: qualify dual-bar production pack
    [pocketforge-node-chassis.scad]
2026-08-03 fix: align qualified cut-list metadata
2026-08-04 Protect TrimUI Brick bottom I/O from supports
    [trimui-brick-cradle.scad]
2026-08-04 Add TrimUI Brick prototype device pack
    [pocketforge-node-chassis.scad, trimui-brick-cradle.scad]
2026-08-05 Inset shared chassis crossbar joints
    [pocketforge-node-chassis.scad]
2026-08-05 Add TG model IDs to Smart Pro labels
    [trimui-smart-pro-cradle.scad, trimui-smart-pro-family-cradle.scad, trimui-smart-pro-s-cradle.scad]
2026-08-05 Add high-fidelity Powkiddy X55 cradle draft
    [powkiddy-x55-cradle.scad]
2026-08-05 Model Powkiddy X55 rear shell curvature
    [powkiddy-x55-cradle.scad]
2026-08-05 tsp-bcx.21.27: standardize X55 labels
    [powkiddy-x55-cradle.scad]
2026-08-05 Add Powkiddy X55 prototype device pack
    [powkiddy-x55-cradle.scad]
2026-08-05 Standardize device packs on continuous fixture bars
2026-08-06 Keep carrier titles inside their borders
    [powkiddy-x55-cradle.scad, trimui-brick-cradle.scad, trimui-smart-pro-family-cradle.scad]
2026-08-06 Give X55 title portable border clearance
    [powkiddy-x55-cradle.scad]
2026-08-06 feat: include DUT fixture in full device packs
2026-08-06 Integrate accepted dual USB-C interrupter holder
    [pocketforge-node-chassis.scad]
2026-08-06 fix(device-packs): preserve browser fingerprints (tsp-bcx.21.43.4)
    [pocketforge-node-chassis-usb-c.scad]
2026-09-08 Model ALT-1205T PSU and fused IEC inlet
    [power-system-models.scad]
2026-09-08 Add PSU and IEC fit coupon
    [power-system-fit-coupon.scad]
2026-09-08 Harden coupon overrides and evidence
    [power-system-fit-coupon.scad]
2026-09-08 test(mechanical): measure rendered IEC clearance
    [power-system-models.scad]
2026-09-08 fix(mechanical): add physical PSU datum register
    [power-system-fit-coupon.scad]
2026-09-08 fix(mechanical): correct power fit coupon datums
    [power-system-fit-coupon.scad]
2026-09-09 fix(mechanical): remove coupon print lettering
    [power-system-fit-coupon.scad]
2026-09-09 fix(mechanical): apply second power fit corrections
    [power-system-fit-coupon.scad]
2026-09-09 fix(mechanical): refine PSU and IEC coupon fit
    [power-system-fit-coupon.scad]
2026-09-09 fix(mechanical): finalize power coupon edge holes
    [power-system-fit-coupon.scad]
2026-09-09 fix(mechanical): apply release PSU hole correction
    [power-system-fit-coupon.scad]
2026-09-09 Add protected single-supply enclosure candidate
    [power-system-enclosure.scad]
2026-09-09 Repair enclosure safety geometry
    [power-system-enclosure.scad]
2026-09-09 fix(mechanical): make enclosure nuts pressure-fit accessible
    [power-system-enclosure.scad]
2026-09-09 fix(mechanical): clear rear hood fastener from C14
    [power-system-enclosure.scad]
2026-09-09 fix(mechanical): move fourth hood fastener to rear
    [power-system-enclosure.scad]
2026-09-12 fix(mechanical): redesign power enclosure for support-free ABS
    [power-system-enclosure.scad]
2026-09-12 fix(mechanical): eliminate enclosure support hazards
    [power-system-enclosure.scad]
